DangerousPrototypes/Bus_Pirate_Ultra/hardware/scratch/BusPirate-ultra-proto-adj_vreg.v.0.brd

## EAGLE design hardware/scratch/BusPirate-ultra-proto-adj_vreg.v.0.brd (2019-07-15)

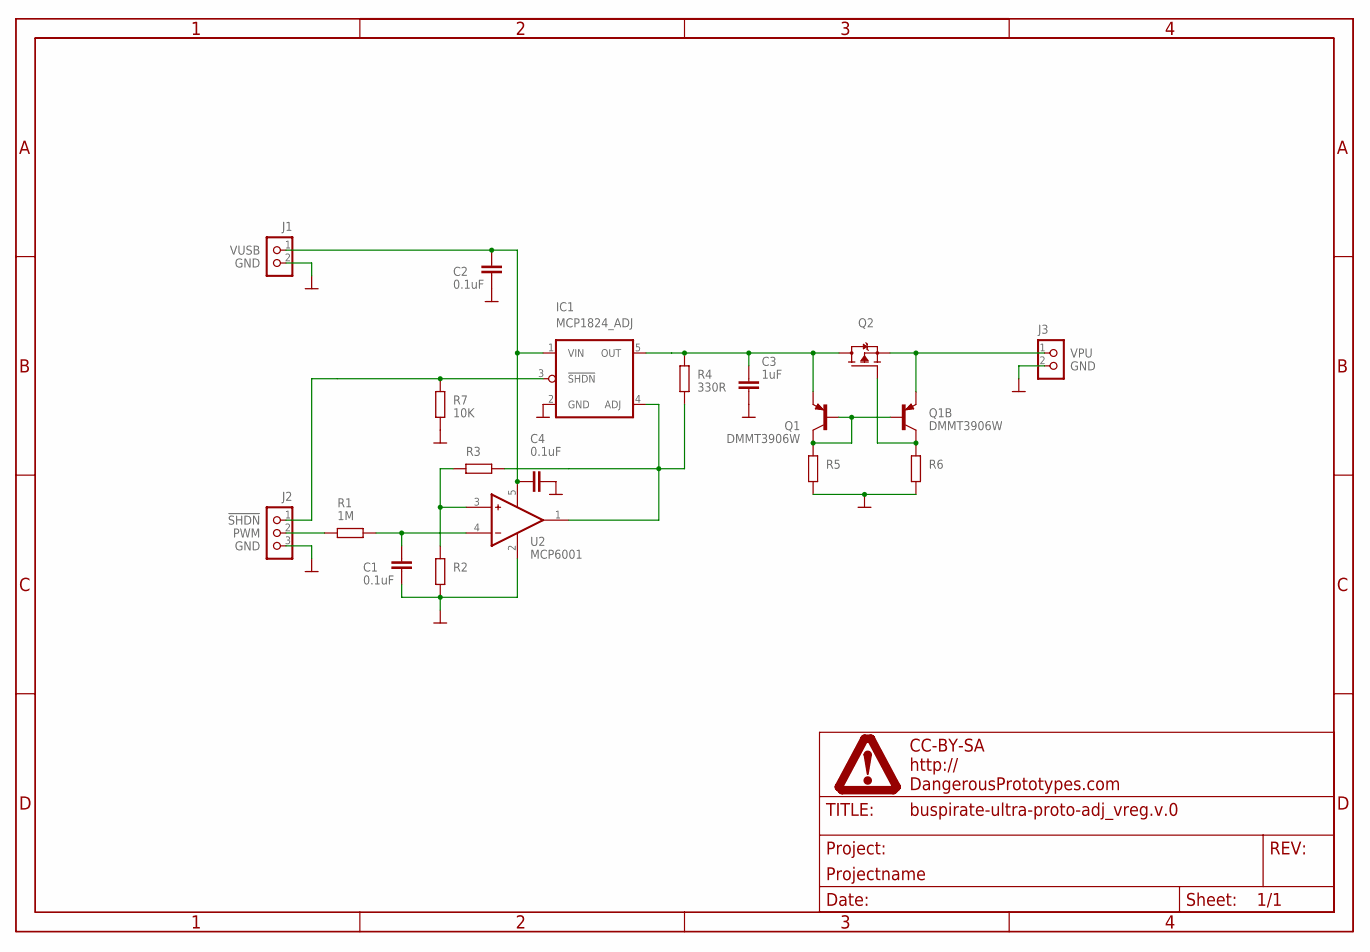
[picture p1: schematic BusPirate-ultra-proto-adj_vreg.v.0.sch]

Parts:
C1, C2, C4: 0.1uF; C603
C3: 1uF; C603
IC1: MCP1824_ADJ; SOT-23-5
J1, J3: CON_HEADER_1X02-PTH; M1X2
J2: CON_HEADER_1X03-PTH; M1X3
PAGE1: FRAME_DINA4_L; DP_LOGO
Q1: DMMT3906W; SOT-363
Q2: TRANSISTOR_FET_TSM2301CX; SOT-23
R1: 1M; R603
R2, R3, R5, R6: RESISTOR-0603; R603
R4: 330R; R603
R7: 10K; R603
U2: MCP6001; SOT-23-5

Connections:
!SHDN: IC1.3 (!SHDN), J2.1, R7.1
GND: C1.2, C2.2, C3.2, C4.2, IC1.2 (GND), J1.2, J2.3, J3.2, R2.2, R5.1, R6.1, R7.2, U2.2 (V-)
unnamed: C3.1, IC1.5 (OUT), Q1.4 (E), Q2.3 (D), R4.2
unnamed: Q1.1 (B), Q1.2 (B), Q1.3 (C), R5.2
unnamed: Q1.6 (C), Q2.1 (G), R6.2
unnamed: IC1.4 (ADJ), R3.1, R4.1, U2.1 (OUT)
unnamed: R2.1, R3.2, U2.3 (+)
unnamed: C1.1, R1.1, U2.4 (-)
PWM: J2.2, R1.2
VPU: J3.1, Q1.5 (E), Q2.2 (S)
VUSB: C2.1, C4.1, IC1.1 (VIN), J1.1, U2.5 (V+)

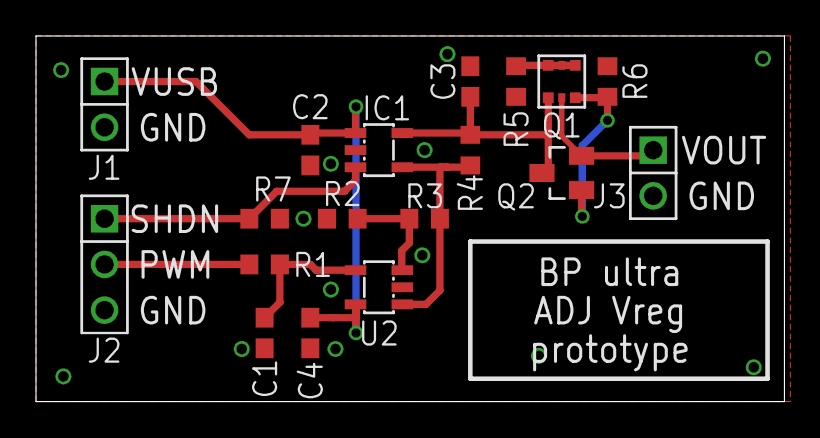
[picture p2: board BusPirate-ultra-proto-adj_vreg.v.0.brd from above]

Board: 2 copper layers, 41.6 x 20.3 mm, 19 parts (0 on the bottom side), 11 nets.
