DangerousPrototypes/Bus_Pirate_Ultra/hardware/scratch/BusPirate-ultra-testboard.v1.0.brd

## EAGLE design hardware/scratch/BusPirate-ultra-testboard.v1.0.brd (2019-07-15)

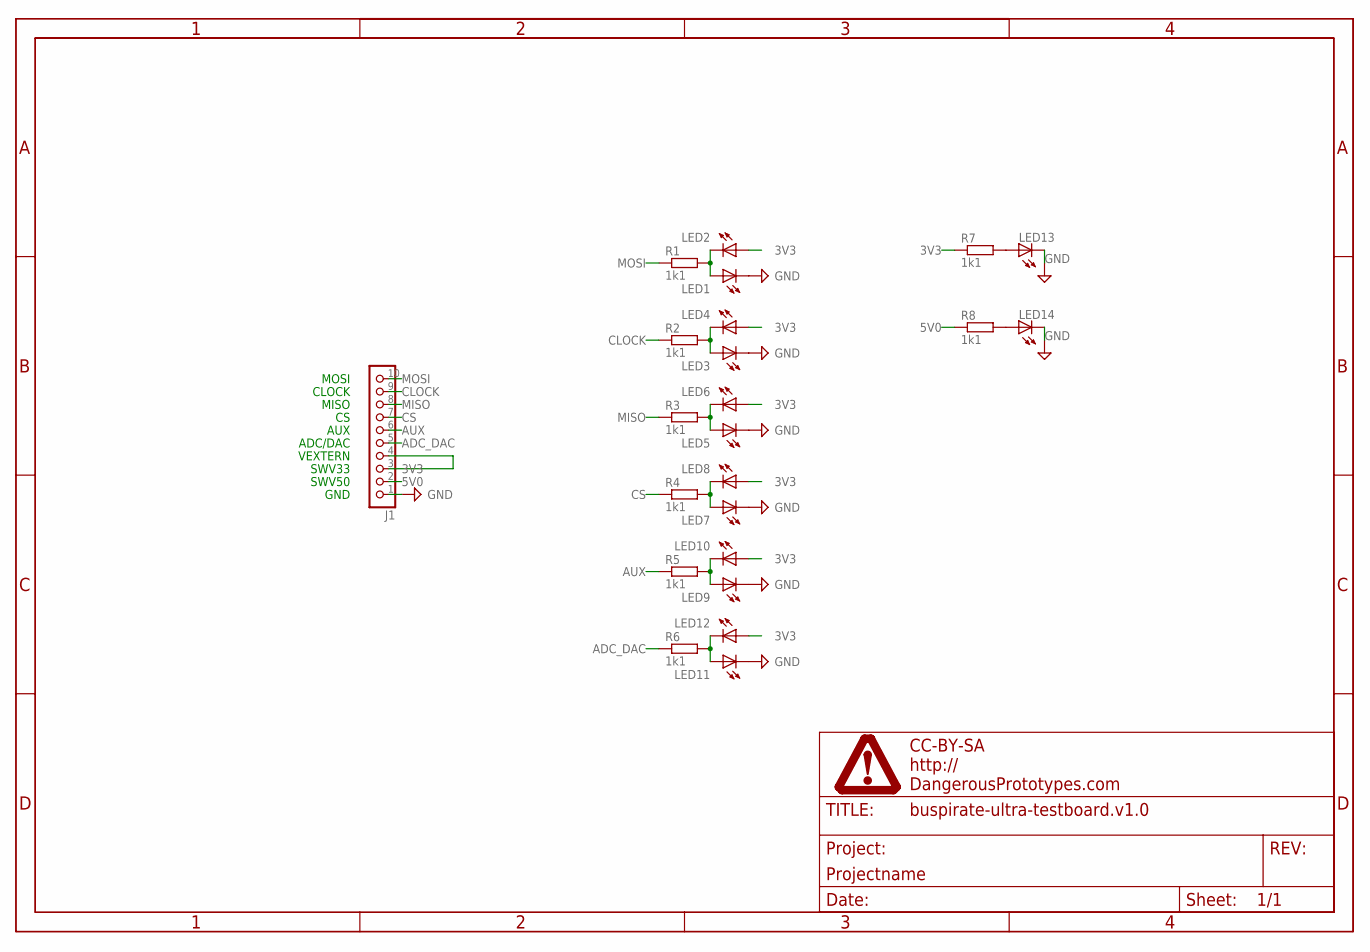
[picture p3: schematic BusPirate-ultra-testboard.v1.0.sch]

Parts:
J1: CON_HEADER_1X10-RIGHT_ANGLED_PTH; M1X10_FEMALE_RIGHT_ANGLED_PTH
LED1, LED2, LED3, LED4, LED5, LED6, LED7, LED8, LED9, LED10, LED11, LED12, LED13, LED14: LED-0805; LED-805
PAGE1: FRAME_DINA4_L; DP_LOGO
R1, R2, R3, R4, R5, R6, R7, R8: 1k1; R603

Connections:
3V3: J1.3, J1.4, LED2.A, LED4.A, LED6.A, LED8.A, LED10.A, LED12.A, R7.1
5V0: J1.2, R8.1
ADC_DAC: J1.5, R6.1
AUX: J1.6, R5.1
CLOCK: J1.9, R2.1
CS: J1.7, R4.1
GND: J1.1, LED1.C, LED3.C, LED5.C, LED7.C, LED9.C, LED11.C, LED13.C, LED14.C
MISO: J1.8, R3.1
MOSI: J1.10, R1.1
unnamed: LED1.A, LED2.C, R1.2
unnamed: LED3.A, LED4.C, R2.2
unnamed: LED5.A, LED6.C, R3.2
unnamed: LED7.A, LED8.C, R4.2
unnamed: LED9.A, LED10.C, R5.2
unnamed: LED11.A, LED12.C, R6.2
unnamed: LED14.A, R8.2
unnamed: LED13.A, R7.2

Notes on the sheet:
MOSI
CLOCK
MISO
AUX
ADC/DAC
VEXTERN
SWV33
SWV50
GND

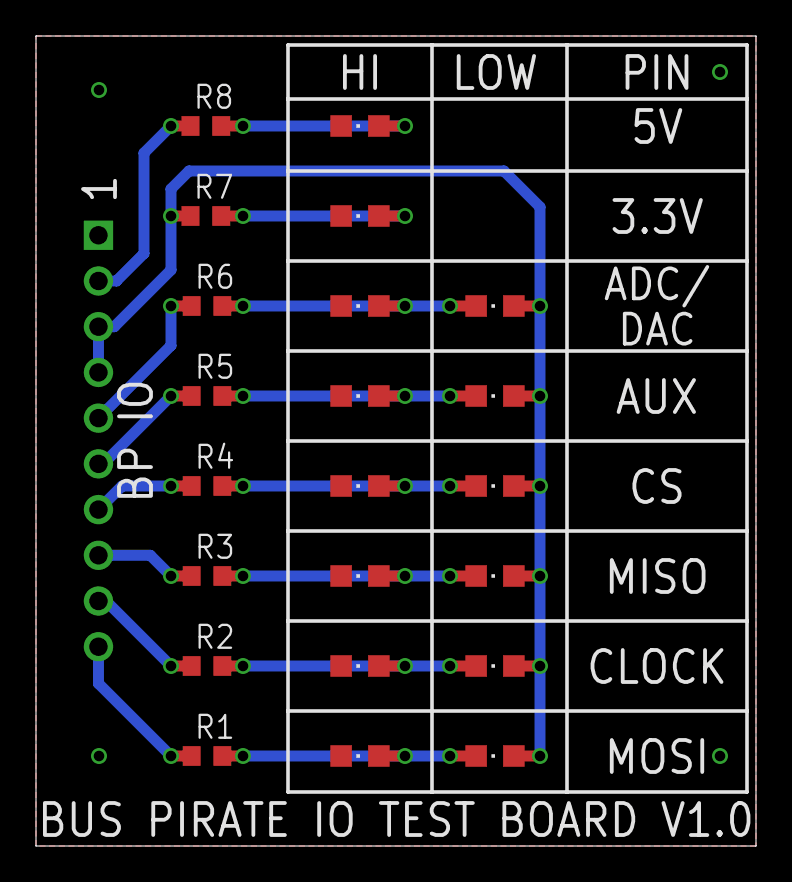
[picture p4: board BusPirate-ultra-testboard.v1.0.brd from above]

Board: 2 copper layers, 40.0 x 45.0 mm, 24 parts (1 on the bottom side), 17 nets.
