DangerousPrototypes/Bus_Pirate_Ultra/hardware/scratch/BusPirate-ng.v4.0.brd

## EAGLE design hardware/scratch/BusPirate-ng.v4.0.brd (2019-06-05)

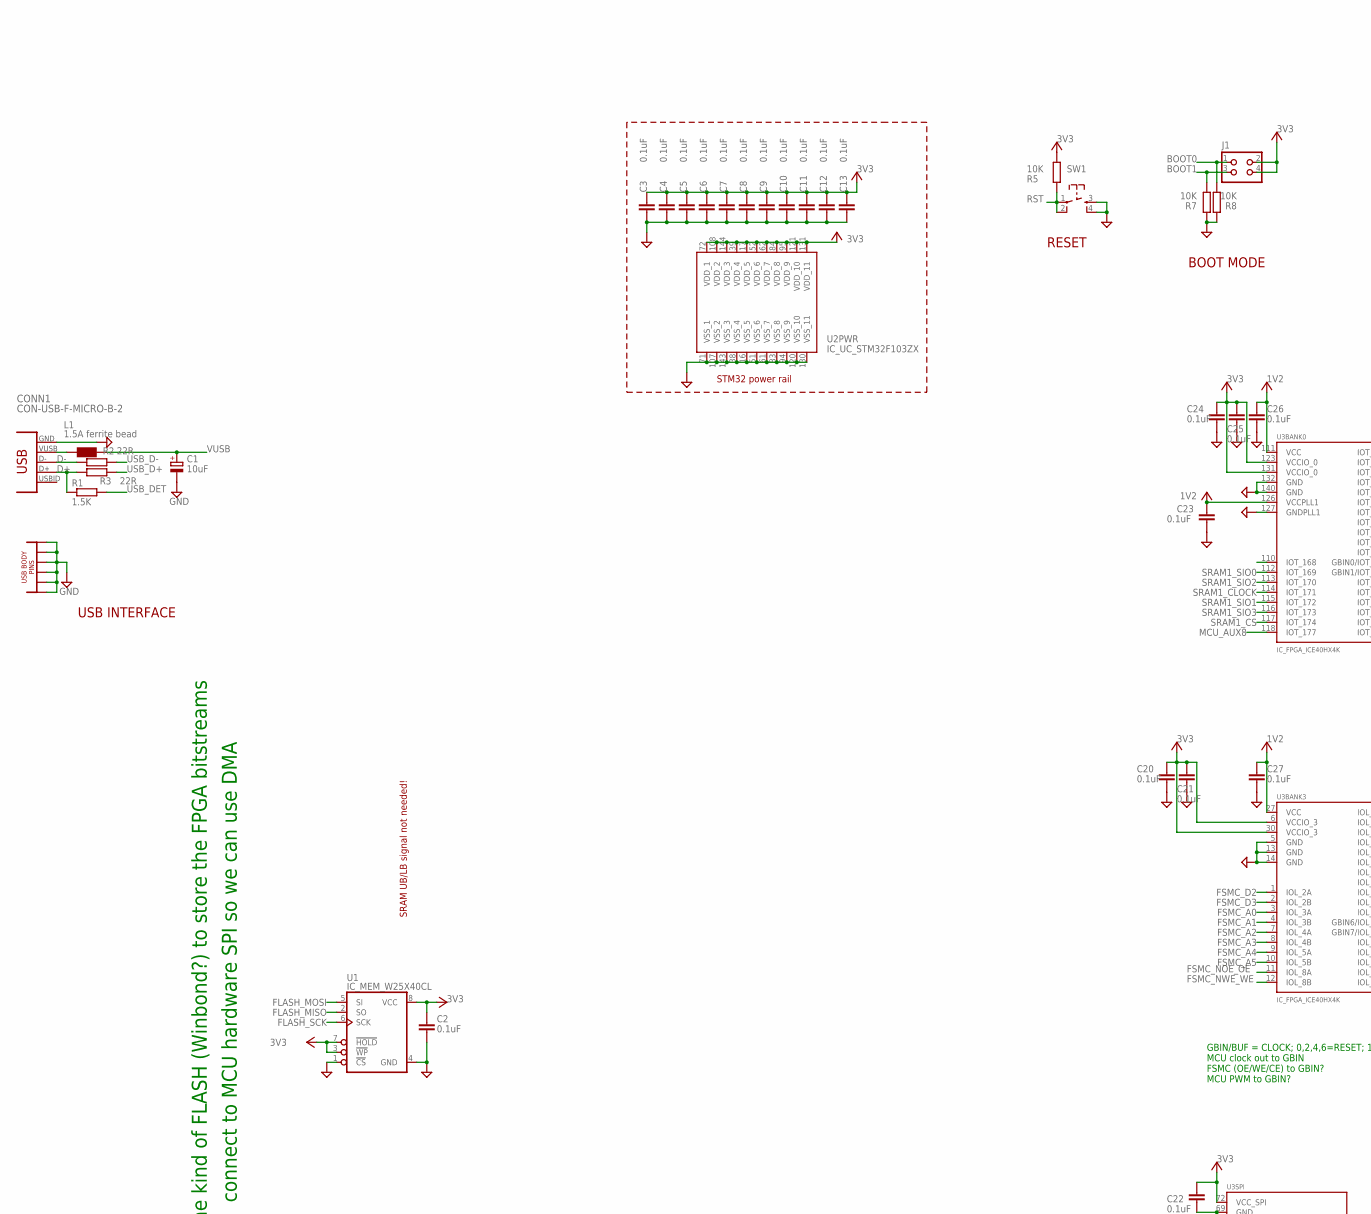
[picture p5: schematic BusPirate-ng.v4.0.sch, part in row 1, column 1]

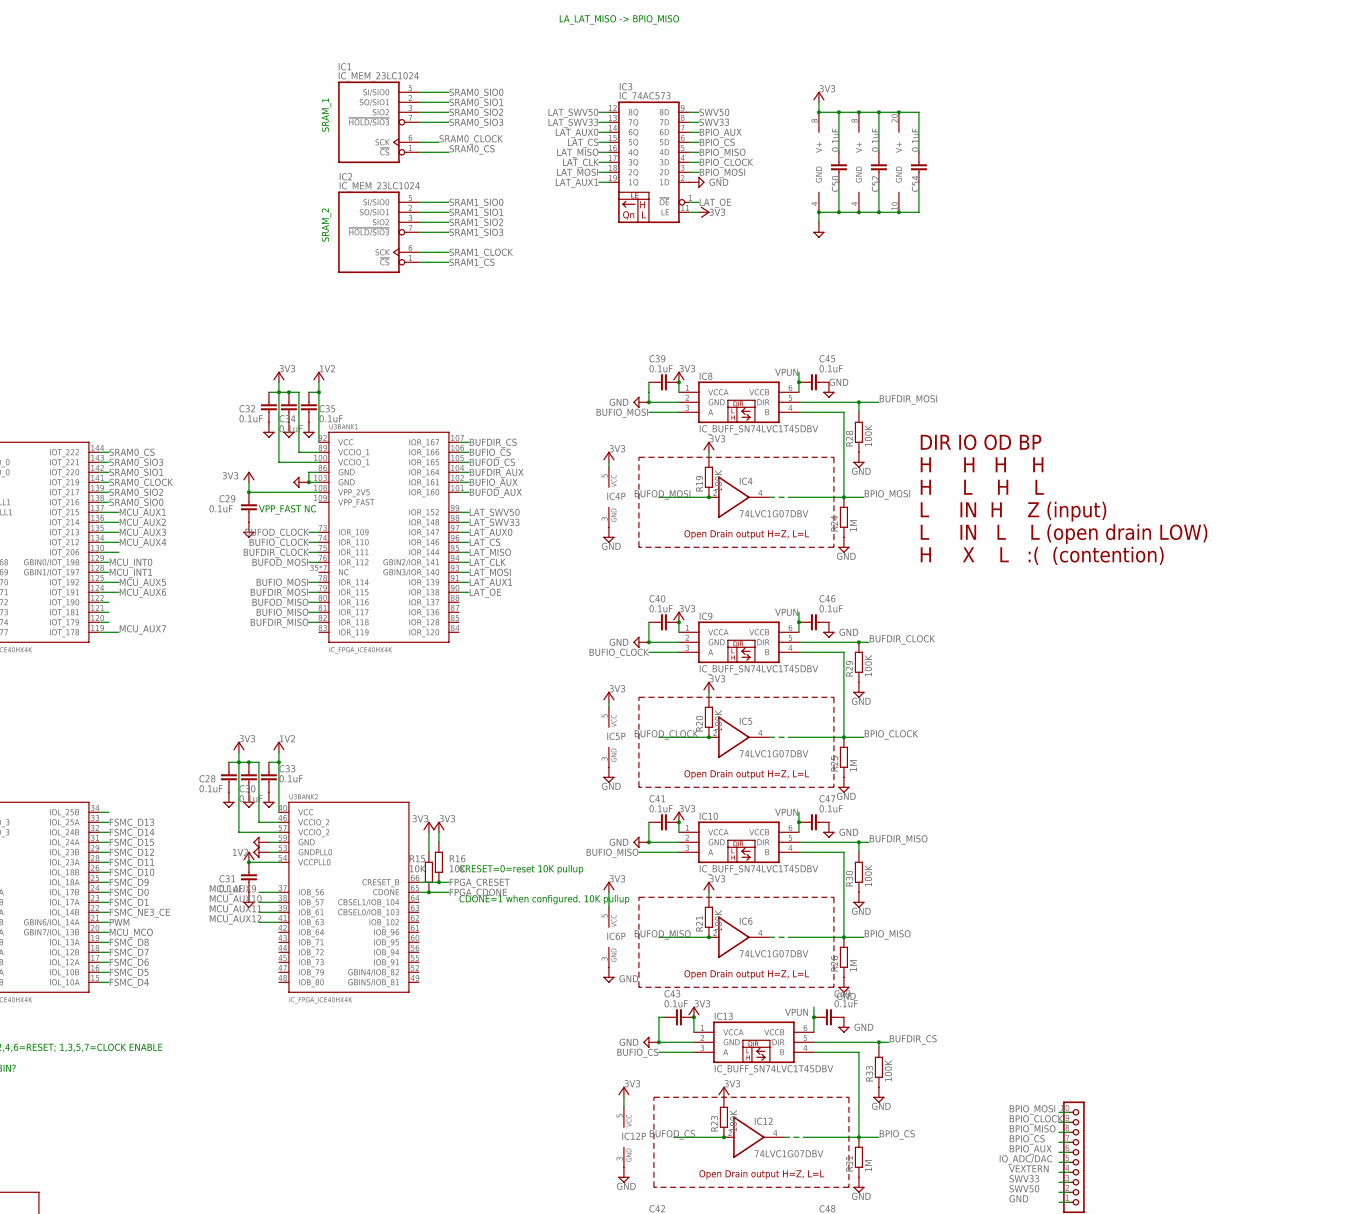
[picture p6: schematic BusPirate-ng.v4.0.sch, part in row 1, column 2]

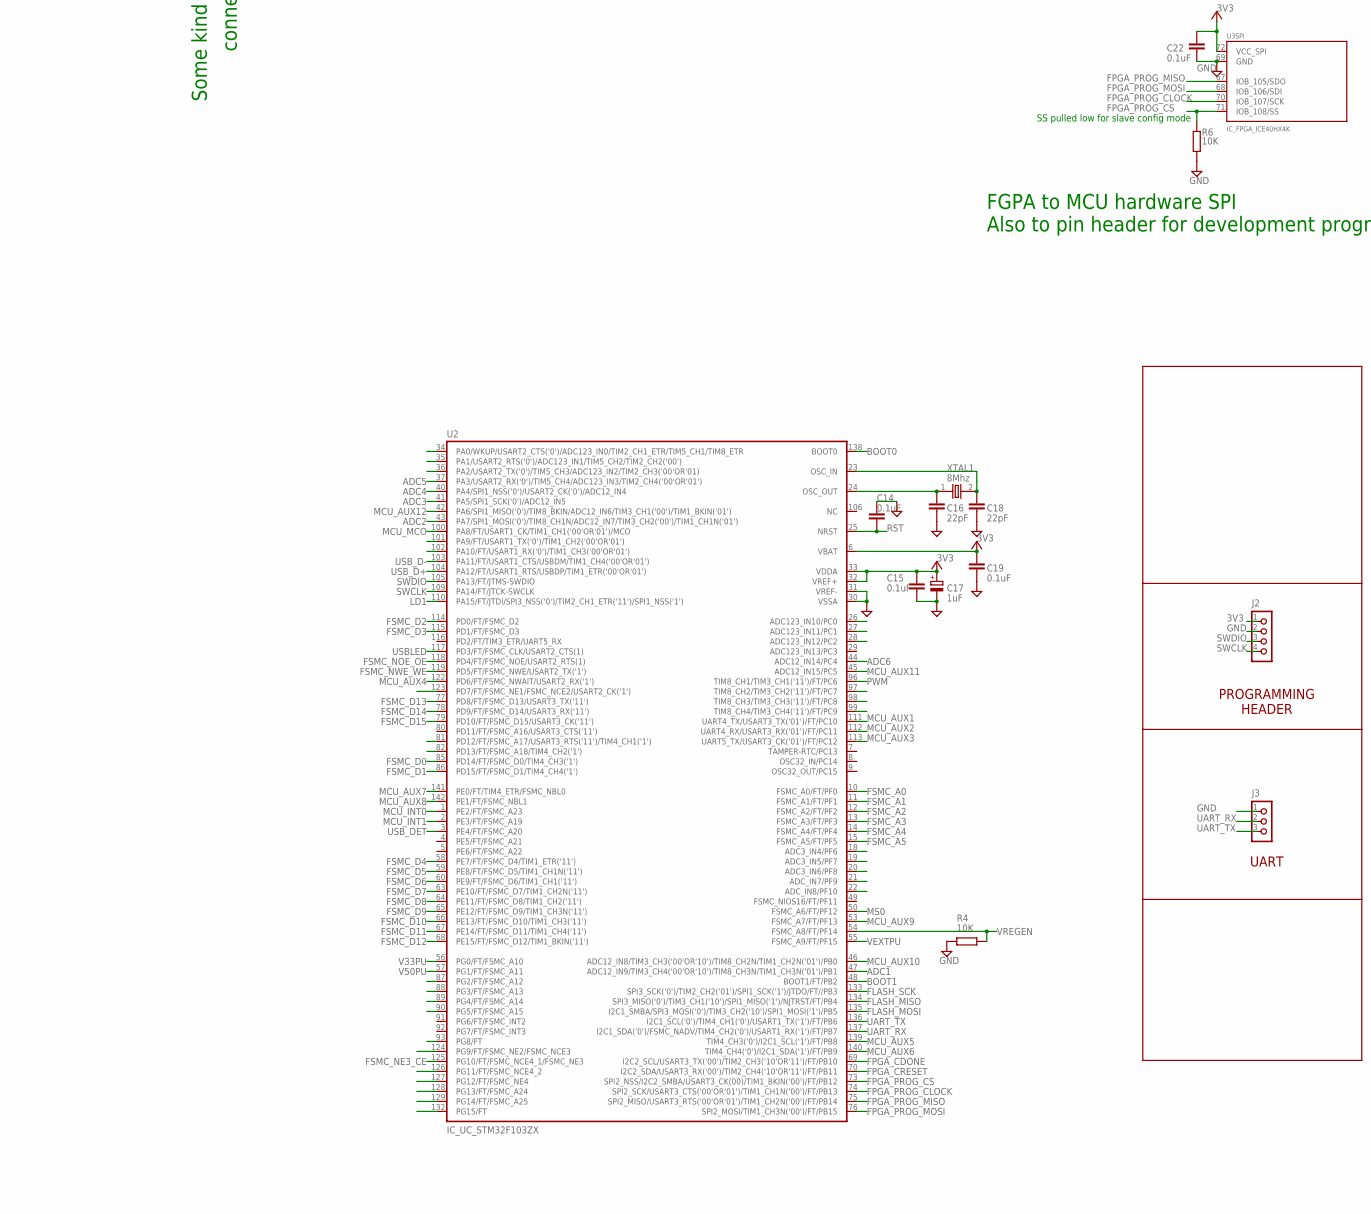
[picture p7: schematic BusPirate-ng.v4.0.sch, part in row 2, column 1]

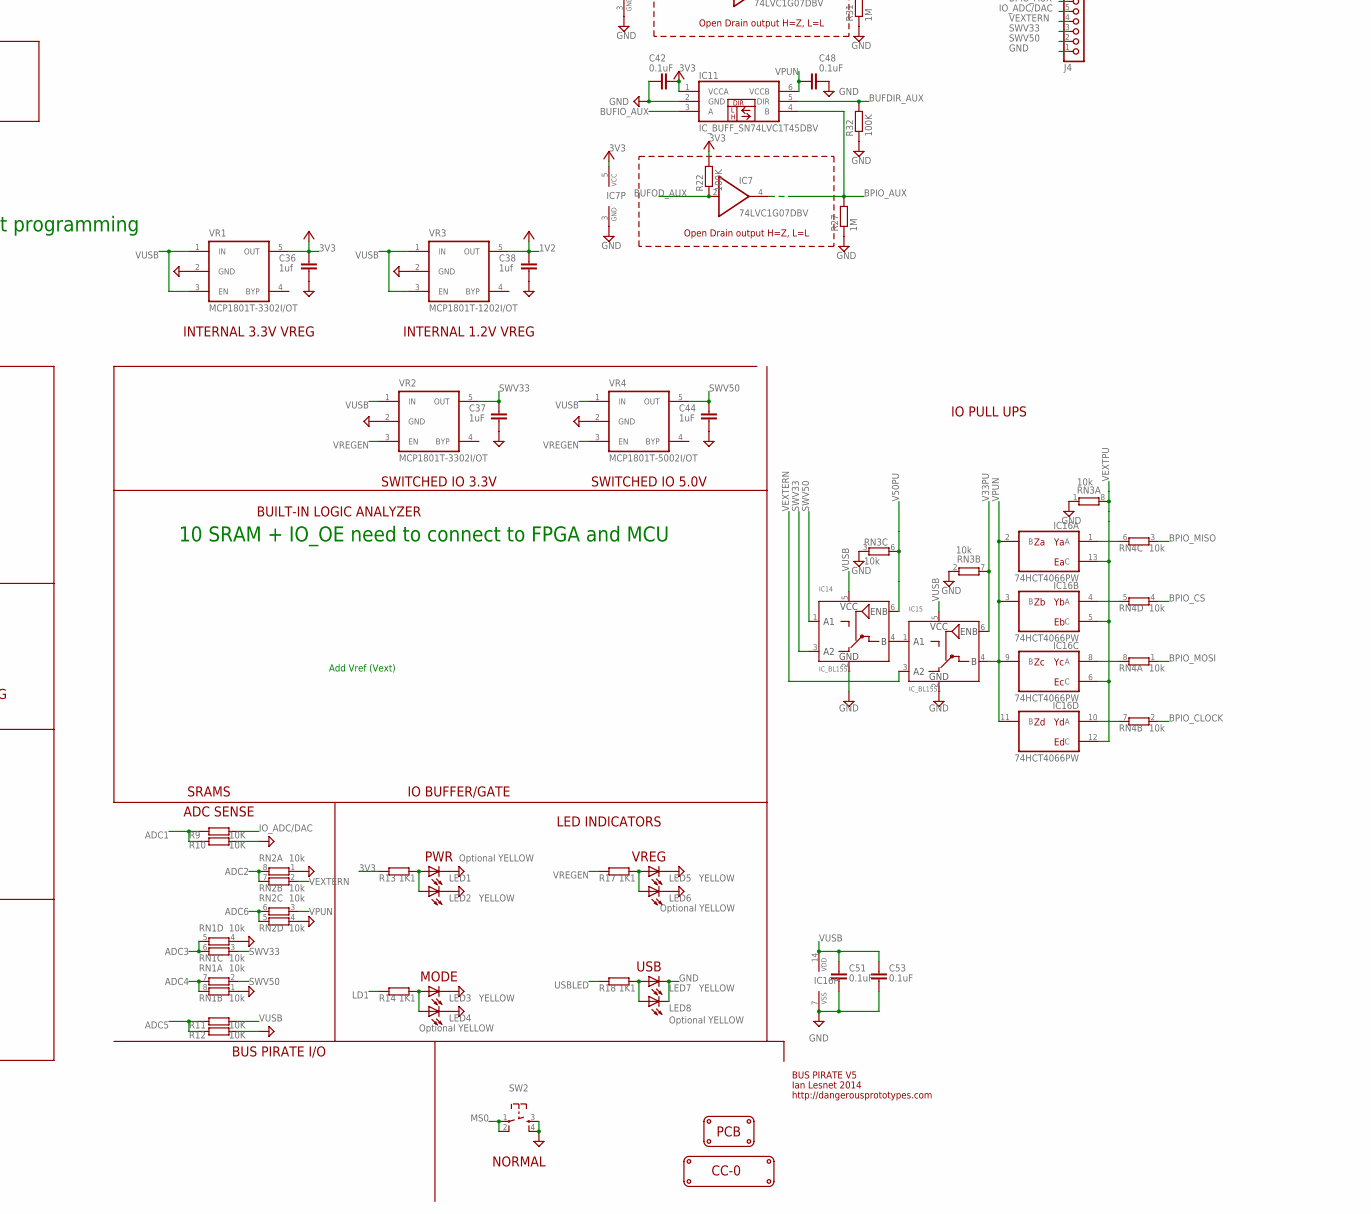
[picture p8: schematic BusPirate-ng.v4.0.sch, part in row 2, column 2]

Parts:
C1: 10uF; SMC_A
C2, C3, C4, C5, C6, C7, C8, C9, C11, C12, C13, C14, C15, C19, C21, C22, C23, C24, C25, C26, C28, C29, C30, C31, C32, C33, C34, C35, C39, C40, C41, C42, C43, C45, C46, C47, C48, C49, C50, C51, C52, C53, C54: 0.1uF; C0603
C10, C20, C27: 0.1uF; C402
C16, C18: 22pF; C0603
C17: 1uF; SMC_A
C36, C38: 1uf; C0603
C37, C44: 1uF; C0603
CONN1: CON-USB-F-MICRO-B-2; CON_USB_MICRO-B-2-SD-47589-001
IC1, IC2: IC_MEM_23LC1024; SOIC-8
IC3: IC_74AC573; TSSOP-20
IC4, IC5, IC6, IC7, IC12: 74LVC1G07DBV; SOT23-5
IC8, IC9, IC10, IC11, IC13: IC_BUFF_SN74LVC1T45DBV; DBV-R-PDSO-G6
IC14, IC15: IC_BL1551; SC-70-6
IC16: 74HCT4066PW; 40XX_TSSOP14
J1: CON_HEADER_2X02-PTH; M2X2
J2: CON_HEADER_1X04; M1X4
J3: CON_HEADER_1X03-PTH; M1X3
J4: CON_HEADER_1X10-RIGHT_ANGLED_PTH_SHROUDED; M1X10_MALE_RIGHT_ANGLES_PTH_SHROUDED
L1: 1.5A ferrite bead; WE-KI_0805_B
LED1, LED4, LED6, LED8: Optional YELLOW; LED-805
LED2, LED3, LED5, LED7: YELLOW; LED-805
LOGO1: LOGO_CC-0
PCB1: PCB_DP_RECTANGLE-50X100; DP10050_V1
R1: 1.5K; R603
R2, R3: 22R; R603
R4, R5, R6: 10K; R603
R7, R8, R9, R10, R11, R12, R15, R16: 10K; R0603
R13, R14, R17, R18: 1K1; R603
R19, R20, R21, R22, R23, R28, R29, R30, R32, R33: 100K; R0603
R24, R25, R26, R27, R31: 1M; R0603
RN1, RN2, RN3, RN4: 10k; RN8P-4R-CRA06S
SW1, SW2: SW_TACT_4P; SW_TACT_SMALL
U1: IC_MEM_W25X40CL; SOIC-8
U2: IC_UC_STM32F103ZX; TQFP-144
U3: IC_FPGA_ICE40HX4K; TQFP-144
VR1, VR2: MCP1801T-3302I/OT; SOT-23-5@1
VR3: MCP1801T-1202I/OT; SOT-23-5@1
VR4: MCP1801T-5002I/OT; SOT-23-5@1
XTAL1: 8Mhz; XTAL_4X6

Connections:
1V2: C23.2, C26.2, C27.1, C31.2, C33.2, C35.2, C38.1, U3.27 (VCC), U3.40 (VCC), U3.54 (VCCPLL0), U3.92 (VCC), U3.111 (VCC), U3.126 (VCCPLL1), VR3.5 (OUT)
3V3: C2.2, C3.2, C4.2, C5.2, C6.2, C7.2, C8.2, C9.2, C10.1, C11.2, C12.2, C13.2, C15.2, C17.+, C19.2, C20.1, C21.2, C22.2, C24.2, C25.2, C28.2, C29.2, C30.2, C32.2, C34.2, C36.1, C39.1, C40.1, C41.1, C42.1, C43.1, C50.1, C52.1, C54.1, IC1.8 (V+), IC2.8 (V+), IC3.11 (LE), IC3.20 (V+), IC4.5 (VCC), IC5.5 (VCC), IC6.5 (VCC), IC7.5 (VCC), IC8.1 (VCCA), IC9.1 (VCCA), IC10.1 (VCCA), IC11.1 (VCCA), IC12.5 (VCC), IC13.1 (VCCA), J1.2, J1.4, J2.1, R5.2, R13.2, R15.2, R16.2, R19.2, R20.2, R21.2, R22.2, R23.2, U1.3 (!WP), U1.7 (!HOLD), U1.8 (VCC), U2.6 (VBAT), U2.17 (VDD_5), U2.32 (VREF+), U2.33 (VDDA), U2.39 (VDD_4), U2.52 (VDD_6), U2.62 (VDD_7), U2.72 (VDD_1), U2.84 (VDD_8), U2.95 (VDD_9), U2.108 (VDD_2), U2.121 (VDD_10), U2.131 (VDD_11), U2.144 (VDD_3), U3.6 (VCCIO_3), U3.30 (VCCIO_3), U3.46 (VCCIO_2), U3.57 (VCCIO_2), U3.72 (VCC_SPI), U3.89 (VCCIO_1), U3.100 (VCCIO_1), U3.108 (VPP_2V5), U3.123 (VCCIO_0), U3.131 (VCCIO_0), VR1.5 (OUT)
ADC1: R9.2, R10.2, U2.47 (ADC12_IN9/TIM3_CH4('00'OR'10')/TIM8_CH3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)
ADC2: RN2.7 (2), RN2.8 (2), U2.43 (PA7/SPI1_MOSI('0')/TIM8_CH1N/ADC12_IN7/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)
ADC3: RN1.5 (2), RN1.6 (2), U2.41 (PA5/SPI1_SCK('0')/ADC12_IN5)
ADC4: RN1.7 (2), RN1.8 (2), U2.40 (PA4/SPI1_NSS('0')/USART2_CK('0')/ADC12_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)
ADC5: R11.2, R12.2, U2.37 (PA3/USART2_RX('0')/TIM5_CH4/ADC123_IN3/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)
ADC6: RN2.5 (2), RN2.6 (2), U2.44 (ADC12_IN14/PC4)
BOOT0: J1.1, R8.1, U2.138 (BOOT0)
BOOT1: J1.3, R7.1, U2.48 (BOOT1/FT/PB2)
BPIO_AUX: IC3.7 (6D), IC7.4 (O), IC11.4 (B), J4.6, R27.2
BPIO_CLOCK: IC3.4 (3D), IC5.4 (O), IC9.4 (B), J4.9, R25.2, RN4.2 (1)
BPIO_CS: IC3.6 (5D), IC12.4 (O), IC13.4 (B), J4.7, R31.2, RN4.4 (1)
BPIO_MISO: IC3.5 (4D), IC6.4 (O), IC10.4 (B), J4.8, R26.2, RN4.3 (1)
BPIO_MOSI: IC3.3 (2D), IC4.4 (O), IC8.4 (B), J4.10, R24.2, RN4.1
BUFDIR_AUX: IC11.5 (DIR), R32.2, U3.104 (IOR_164)
BUFDIR_CLOCK: IC9.5 (DIR), R29.2, U3.75 (IOR_111)
BUFDIR_CS: IC13.5 (DIR), R33.2, U3.107 (IOR_167)
BUFDIR_MISO: IC10.5 (DIR), R30.2, U3.82 (IOR_118)
BUFDIR_MOSI: IC8.5 (DIR), R28.2, U3.79 (IOR_115)
BUFIO_AUX: IC11.3 (A), U3.102 (IOR_161)
BUFIO_CLOCK: IC9.3 (A), U3.74 (IOR_110)
BUFIO_CS: IC13.3 (A), U3.106 (IOR_166)
BUFIO_MISO: IC10.3 (A), U3.81 (IOR_117)
BUFIO_MOSI: IC8.3 (A), U3.78 (IOR_114)
BUFOD_AUX: IC7.2 (I), R22.1, U3.101 (IOR_160)
BUFOD_CLOCK: IC5.2 (I), R20.1, U3.73 (IOR_109)
BUFOD_CS: IC12.2 (I), R23.1, U3.105 (IOR_165)
BUFOD_MISO: IC6.2 (I), R21.1, U3.80 (IOR_116)
BUFOD_MOSI: IC4.2 (I), R19.1, U3.76 (IOR_112)
D+: CONN1.P3 (D+), R1.1, R3.2
D-: CONN1.P2 (D-), R2.2
EXVUSB: CONN1.P1 (VUSB), L1.2 (1)
FLASH_MISO: U1.2 (SO), U2.134 (SPI3_MISO('0')/TIM3_CH1('10')/SPI1_MISO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)
FLASH_MOSI: U1.5 (SI), U2.135 (I2C1_SMBA/SPI3_MOSI('0')/TIM3_CH2('10')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)
FLASH_SCK: U1.6 (SCK), U2.133 (SPI3_SCK('0')/TIM2_CH2('01')/SPI1_SCK('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)
FPGA_CDONE: R15.1, U2.69 (I2C2_SCL/USART3_TX('00')/TIM2_CH3('10'O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), U3.65 (CDONE)
FPGA_CRESET: R16.1, U2.70 (I2C2_SDA/USART3_RX('00')/TIM2_CH4('10'O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), U3.66 (CRESET_B)
FPGA_PROG_CLOCK: U2.74 (SPI2_SCK/USART3_CTS('00'OR'01')/TIM1_CH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), U3.70 (IOB_107/SCK)
FPGA_PROG_CS: R6.1, U2.73 (SPI2_NSS/I2C2_SMBA/USART3_CK(00)/TIM1_B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), U3.71 (IOB_108/SS)
FPGA_PROG_MISO: U2.75 (SPI2_MISO/USART3_RTS('00'OR'01')/TIM1_C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), U3.67 (IOB_105/SDO)
FPGA_PROG_MOSI: U2.76 (SPI2_MOSI/TIM1_CH3N('00')/FT/PB15), U3.68 (IOB_106/SDI)
FSMC_A0: U2.10 (FSMC_A0/FT/PF0), U3.3 (IOL_3A)
FSMC_A1: U2.11 (FSMC_A1/FT/PF1), U3.4 (IOL_3B)
FSMC_A2: U2.12 (FSMC_A2/FT/PF2), U3.7 (IOL_4A)
FSMC_A3: U2.13 (FSMC_A3/FT/PF3), U3.8 (IOL_4B)
FSMC_A4: U2.14 (FSMC_A4/FT/PF4), U3.9 (IOL_5A)
FSMC_A5: U2.15 (FSMC_A5/FT/PF5), U3.10 (IOL_5B)
FSMC_D0: U2.85 (PD14/FT/FSMC_D0/TIM4_CH3('1')), U3.24 (IOL_17B)
FSMC_D1: U2.86 (PD15/FT/FSMC_D1/TIM4_CH4('1')), U3.23 (IOL_17A)
FSMC_D2: U2.114 (PD0/FT/FSMC_D2), U3.1 (IOL_2A)
FSMC_D3: U2.115 (PD1/FT/FSMC_D3), U3.2 (IOL_2B)
FSMC_D4: U2.58 (PE7/FT/FSMC_D4/TIM1_ETR('11')), U3.15 (IOL_10A)
FSMC_D5: U2.59 (PE8/FT/FSMC_D5/TIM1_CH1N('11')), U3.16 (IOL_10B)
FSMC_D6: U2.60 (PE9/FT/FSMC_D6/TIM1_CH1('11')), U3.17 (IOL_12A)
FSMC_D7: U2.63 (PE10/FT/FSMC_D7/TIM1_CH2N('11')), U3.18 (IOL_12B)
FSMC_D8: U2.64 (PE11/FT/FSMC_D8/TIM1_CH2('11')), U3.19 (IOL_13A)
FSMC_D9: U2.65 (PE12/FT/FSMC_D9/TIM1_CH3N('11')), U3.25 (IOL_18A)
FSMC_D10: U2.66 (PE13/FT/FSMC_D10/TIM1_CH3('11')), U3.26 (IOL_18B)
FSMC_D11: U2.67 (PE14/FT/FSMC_D11/TIM1_CH4('11')), U3.28 (IOL_23A)
FSMC_D12: U2.68 (PE15/FT/FSMC_D12/TIM1_BKIN('11')), U3.29 (IOL_23B)
FSMC_D13: U2.77 (PD8/FT/FSMC_D13/USART3_TX('11')), U3.33 (IOL_25A)
FSMC_D14: U2.78 (PD9/FT/FSMC_D14/USART3_RX('11')), U3.32 (IOL_24B)
FSMC_D15: U2.79 (PD10/FT/FSMC_D15/USART3_CK('11')), U3.31 (IOL_24A)
FSMC_NE3_CE: U2.125 (PG10/FT/FSMC_NCE4_1/FSMC_NE3), U3.22 (IOL_14B)
FSMC_NOE_OE: U2.118 (PD4/FT/FSMC_NOE/USART2_RTS(1)), U3.11 (IOL_8A)
FSMC_NWE_WE: U2.119 (PD5/FT/FSMC_NWE/USART2_TX('1')), U3.12 (IOL_8B)
GND: C1.-, C2.1, C3.1, C4.1, C5.1, C6.1, C7.1, C8.1, C9.1, C10.2, C11.1, C12.1, C13.1, C14.1, C15.1, C16.1, C17.-, C18.1, C19.1, C20.2, C21.1, C22.1, C23.1, C24.1, C25.1, C26.1, C27.2, C28.1, C29.1, C30.1, C31.1, C32.1, C33.1, C34.1, C35.1, C36.2, C37.2, C38.2, C39.2, C40.2, C41.2, C42.2, C43.2, C44.2, C45.1, C46.1, C47.1, C48.1, C49.1, C50.2, C51.2, C52.2, C53.2, C54.2, CONN1.BODY@1, CONN1.BODY@2, CONN1.BODY@3, CONN1.BODY@4, CONN1.BODY@5, CONN1.BODY@6, CONN1.BODY@7, CONN1.BODY@8, CONN1.BODY@9, CONN1.BODY@10, CONN1.P5 (GND), IC1.4 (GND), IC2.4 (GND), IC3.2 (1D), IC3.10 (GND), IC4.3 (GND), IC5.3 (GND), IC6.3 (GND), IC7.3 (GND), IC8.2 (GND), IC9.2 (GND), IC10.2 (GND), IC11.2 (GND), IC12.3 (GND), IC13.2 (GND), IC14.2 (GND), IC15.2 (GND), IC16.7 (VSS), J2.2, J3.1, J4.1, LED1.C, LED2.C, LED3.C, LED4.C, LED5.C, LED6.C, LED7.C, LED8.C, R4.2, R6.2, R7.2, R8.2, R10.1, R12.1, R24.1, R25.1, R26.1, R27.1, R28.1, R29.1, R30.1, R31.1, R32.1, R33.1, RN1.1, RN1.4 (1), RN2.1, RN2.4 (1), RN3.1, RN3.2 (1), RN3.3 (1), SW1.3, SW1.4, SW2.3, SW2.4, U1.1 (!CS), U1.4 (GND), U2.16 (VSS_5), U2.30 (VSSA), U2.31 (VREF-), U2.38 (VSS_4), U2.51 (VSS_6), U2.61 (VSS_7), U2.71 (VSS_1), U2.83 (VSS_8), U2.94 (VSS_9), U2.107 (VSS_2), U2.120 (VSS_10), U2.130 (VSS_11), U2.143 (VSS_3), U3.5 (GND), U3.13 (GND), U3.14 (GND), U3.53 (GNDPLL0), U3.59 (GND), U3.69 (GND), U3.86 (GND), U3.103 (GND), U3.127 (GNDPLL1), U3.132 (GND), U3.140 (GND), VR1.2 (GND), VR2.2 (GND), VR3.2 (GND), VR4.2 (GND)
IO_ADC/DAC: J4.5, R9.1
LAT_AUX0: IC3.14 (6Q), U3.97 (IOR_147)
LAT_AUX1: IC3.19 (1Q), U3.91 (IOR_139)
LAT_CLK: IC3.17 (3Q), U3.94 (GBIN2/IOR_141)
LAT_CS: IC3.15 (5Q), U3.96 (IOR_146)
LAT_MISO: IC3.16 (4Q), U3.95 (IOR_144)
LAT_MOSI: IC3.18 (2Q), U3.93 (GBIN3/IOR_140)
LAT_OE: IC3.1 (!OE), U3.90 (IOR_138)
LAT_SWV33: IC3.13 (7Q), U3.98 (IOR_148)
LAT_SWV50: IC3.12 (8Q), U3.99 (IOR_152)
LD1: R14.2, U2.110 (PA15/FT/JTDI/SPI3_NSS('0')/TIM2_CH1_ETR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)
MCU_AUX1: U2.111 (UART4_TX/USART3_TX('01')/FT/PC10), U3.137 (IOT_215)
MCU_AUX2: U2.112 (UART4_RX/USART3_RX('01')/FT/PC11), U3.136 (IOT_214)
MCU_AUX3: U2.113 (UART5_TX/USART3_CK('01')/FT/PC12), U3.135 (IOT_213)
MCU_AUX4: U2.122 (PD6/FT/FSMC_NWAIT/USART2_RX('1')), U3.134 (IOT_212)
MCU_AUX5: U2.139 (TIM4_CH3('0')/I2C1_SCL('1')/FT/PB8), U3.125 (IOT_192)
MCU_AUX6: U2.140 (TIM4_CH4('0')/I2C1_SDA('1')/FT/PB9), U3.124 (IOT_191)
MCU_AUX7: U2.141 (PE0/FT/TIM4_ETR/FSMC_NBL0), U3.119 (IOT_178)
MCU_AUX8: U2.142 (PE1/FT/FSMC_NBL1), U3.118 (IOT_177)
MCU_AUX9: U2.53 (FSMC_A7/FT/PF13), U3.37 (IOB_56)
MCU_AUX10: U2.46 (ADC12_IN8/TIM3_CH3('00'OR'10')/TIM8_CH2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), U3.38 (IOB_57)
MCU_AUX11: U2.45 (ADC12_IN15/PC5), U3.39 (IOB_61)
MCU_AUX12: U2.42 (PA6/SPI1_MISO('0')/TIM8_BKIN/ADC12_IN6/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), U3.41 (IOB_63)
MCU_INT0: U2.1 (PE2/FT/FSMC_A23), U3.129 (GBIN0/IOT_198)
MCU_INT1: U2.2 (PE3/FT/FSMC_A19), U3.128 (GBIN1/IOT_197)
MCU_MCO: U2.100 (PA8/FT/USART1_CK/TIM1_CH1('00'OR'01')/M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), U3.20 (GBIN7/IOL_13B)
MS0: SW2.1, SW2.2, U2.50 (FSMC_A6/FT/PF12)
unnamed: IC14.4 (B), IC15.1 (A1)
unnamed: IC16.1 (A), RN4.6 (2)
unnamed: IC16.4 (A), RN4.5 (2)
unnamed: IC16.8 (A), RN4.8 (2)
unnamed: IC16.10 (A), RN4.7 (2)
unnamed: LED3.A, LED4.A, R14.1
unnamed: LED1.A, LED2.A, R13.1
unnamed: C18.2, U2.23 (OSC_IN), XTAL1.2
unnamed: C16.2, U2.24 (OSC_OUT), XTAL1.1
unnamed: LED7.A, LED8.A, R18.1
unnamed: LED5.A, LED6.A, R17.1
PWM: U2.96 (TIM8_CH1/TIM3_CH1('11')/FT/PC6), U3.21 (GBIN6/IOL_14A)
RST: C14.2, R5.1, SW1.1, SW1.2, U2.25 (NRST)
SRAM0_CLOCK: IC1.6 (SCK), U3.141 (IOT_219)
SRAM0_CS: IC1.1 (!CS), U3.144 (IOT_222)
SRAM0_SIO0: IC1.5 (SI/SIO0), U3.138 (IOT_216)
SRAM0_SIO1: IC1.2 (SO/SIO1), U3.142 (IOT_220)
SRAM0_SIO2: IC1.3 (SIO2), U3.139 (IOT_217)
SRAM0_SIO3: IC1.7 (!HOLD/SIO3), U3.143 (IOT_221)
SRAM1_CLOCK: IC2.6 (SCK), U3.114 (IOT_171)
SRAM1_CS: IC2.1 (!CS), U3.117 (IOT_174)
SRAM1_SIO0: IC2.5 (SI/SIO0), U3.112 (IOT_169)
SRAM1_SIO1: IC2.2 (SO/SIO1), U3.115 (IOT_172)
SRAM1_SIO2: IC2.3 (SIO2), U3.113 (IOT_170)
SRAM1_SIO3: IC2.7 (!HOLD/SIO3), U3.116 (IOT_173)
SWCLK: J2.4, U2.109 (PA14/FT/JTCK-SWCLK)
SWDIO: J2.3, U2.105 (PA13/FT/JTMS-SWDIO)
SWV33: C37.1, IC3.8 (7D), IC14.3 (A2), J4.3, RN1.3 (1), VR2.5 (OUT)
SWV50: C44.1, IC3.9 (8D), IC14.1 (A1), J4.2, RN1.2 (1), VR4.5 (OUT)
UART_RX: J3.2, U2.137 (I2C1_SDA('0')/FSMC_NADV/TIM4_CH2('0')/U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)
UART_TX: J3.3, U2.136 (I2C1_SCL('0')/TIM4_CH1('0')/USART1_TX('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)
USBLED: R18.2, U2.117 (PD3/FT/FSMC_CLK/USART2_CTS(1))
USB_D+: R3.1, U2.104 (PA12/FT/USART1_RTS/USBDP/TIM1_ETR('00'O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)
USB_D-: R2.1, U2.103 (PA11/FT/USART1_CTS/USBDM/TIM1_CH4('00'O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)
USB_DET: R1.2, U2.3 (PE4/FT/FSMC_A20)
V33PU: IC15.6 (ENB), RN3.7 (2), U2.56 (PG0/FT/FSMC_A10)
V50PU: IC14.6 (ENB), RN3.6 (2), U2.57 (PG1/FT/FSMC_A11)
VEXTERN: IC15.3 (A2), J4.4, RN2.2 (1)
VEXTPU: IC16.5 (C), IC16.6 (C), IC16.12 (C), IC16.13 (C), RN3.8 (2), U2.55 (FSMC_A9/FT/PF15)
VPP_FAST: U3.109 (VPP_FAST)
VPUN: C45.2, C46.2, C47.2, C48.2, C49.2, IC8.6 (VCCB), IC9.6 (VCCB), IC10.6 (VCCB), IC11.6 (VCCB), IC13.6 (VCCB), IC15.4 (B), IC16.2 (B), IC16.3 (B), IC16.9 (B), IC16.11 (B), RN2.3 (1)
VREGEN: R4.1, R17.2, U2.54 (FSMC_A8/FT/PF14), VR2.3 (EN), VR4.3 (EN)
VUSB: C1.+, C51.1, C53.1, IC14.5 (VCC), IC15.5 (VCC), IC16.14 (VDD), L1.1 (2), R11.1, VR1.1 (IN), VR1.3 (EN), VR2.1 (IN), VR3.1 (IN), VR3.3 (EN), VR4.1 (IN)

Notes on the sheet:
BUS PIRATE V5
Ian Lesnet 2014
http://dangerousprototypes.com
SRAMS
IO BUFFER/GATE
BUS PIRATE I/O
BOOT MODE
PWR
MODE
VREG
PROGRAMMING HEADER
USB
INTERNAL 3.3V VREG
SWITCHED IO 3.3V
SWITCHED IO 5.0V
BUILT-IN LOGIC ANALYZER
ADC SENSE
USB INTERFACE
NORMAL
RESET
IO PULL UPS
LED INDICATORS
UART
SRAM UB/LB signal not needed!
Open Drain output H=Z, L=L
10 SRAM + IO_OE need to connect to FPGA and MCU
Some kind of FLASH (Winbond?) to store the FPGA bitstreams
connect to MCU hardware SPI so we can use DMA
FGPA to MCU hardware SPI Also to pin header for development programming
SS pulled low for slave config mode
CDONE=1 when configured. 10K pullup
CRESET=0=reset 10K pullup
VPP_FAST NC
GBIN/BUF = CLOCK; 0,2,4,6=RESET; 1,3,5,7=CLOCK ENABLE MCU clock out to GBIN FSMC (OE/WE/CE) to GBIN? MCU PWM to GBIN?
Add Vref (Vext)
DIR IO OD BP H H H H H L H L L IN H Z (input) L IN L L (open drain LOW) H X L :( (contention)
STM32 power rail
INTERNAL 1.2V VREG
SRAM_1
SRAM_2
LA_LAT_MISO -> BPIO_MISO

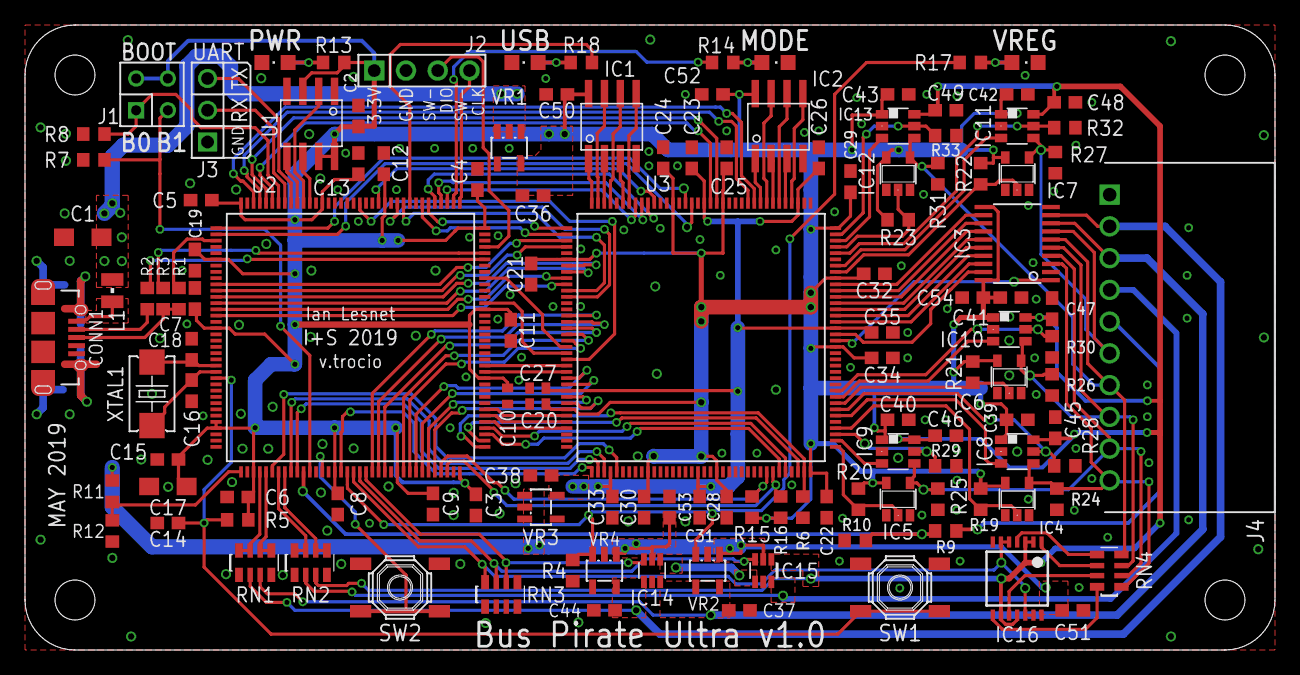
[picture p9: board BusPirate-ng.v4.0.brd from above]

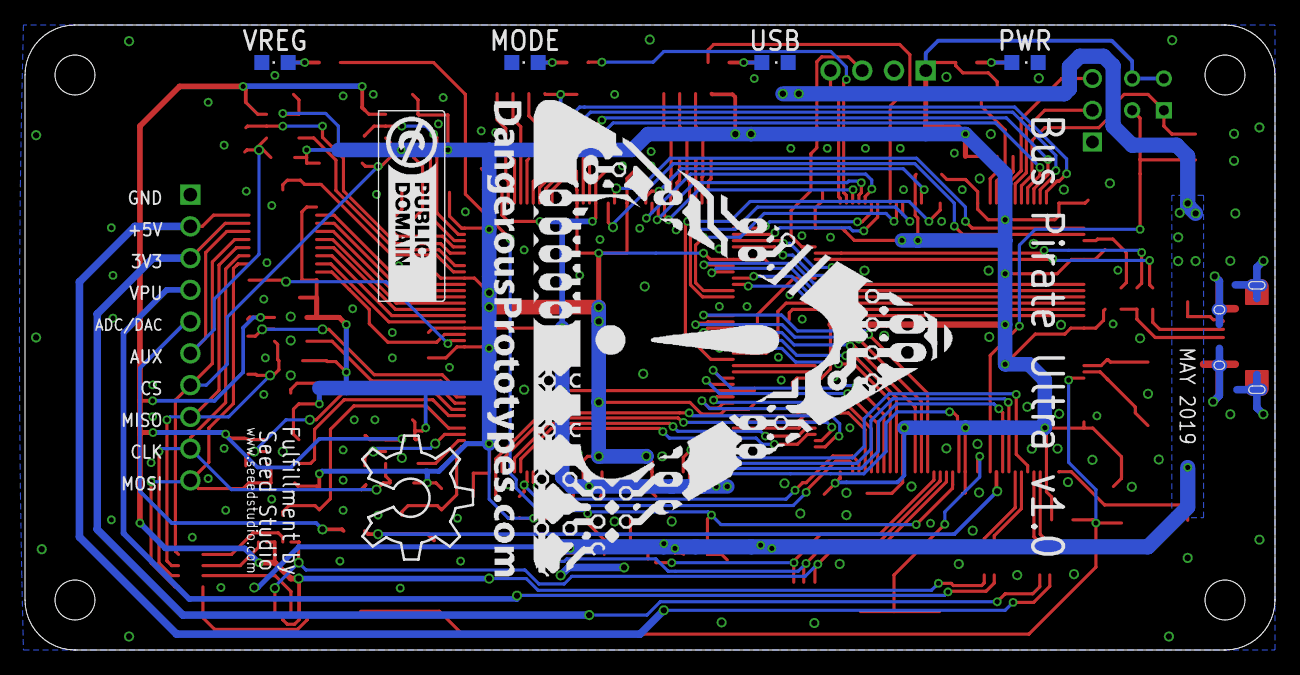
[picture p10: board BusPirate-ng.v4.0.brd from below]

Board: 2 copper layers, 100.0 x 50.0 mm, 136 parts (7 on the bottom side), 137 nets.

Other parts of the board:
U$1: DP-LOGO
U$2: OSHW_8X350_NOTEXT
U$4: DP_LOGO_ART_1.5X1.5
