DangerousPrototypes/Bus_Pirate_Ultra/source/LA.h

void LA_start(void);
uint32_t LA_send(uint32_t d);
uint32_t LA_read(void);
void LA_macro(uint32_t macro);
void LA_setup(void);
void LA_setup_exc(void);
void LA_cleanup(void);
void LA_pins(void);
void LA_settings(void);

//ians test functions
void logicAnalyzerSetup(void);
void logicAnalyzerCaptureStop(void);
void logicAnalyzerCaptureStart(void);
void logicAnalyzerDumpSamples(uint32_t numSamples);
void logicAnalyzerTest(void);

#define LATRIGGERMENU	"Trigger\r\n 1. Rising\r\n 2. Falling\r\n 3. Both\r\n 4. No trigger*\r\n> "
#define LAPERIODMENU 	"period> "
#define LASAMPLEMENU	"samples> "

#define CMDREAD		0x0B
#define CMDWRITE	0x02
#define CMDQUADMODE	0x35
#define CMDREADQUAD 0xEB
//#define CMDSEQLMODE	0xF5
#define CMDRESETSPI	0xF5
#define CMDWRITERREG	0x05

#define la_sram_mode_setup() gpio_set_mode(GPIOE,GPIO_MODE_OUTPUT_50_MHZ, GPIO_CNF_OUTPUT_PUSHPULL,GPIO2);
#define la_sram_mode_quad() gpio_set(GPIOE,GPIO2)
#define la_sram_mode_spi() gpio_clear(GPIOE,GPIO2)
#define la_sram_quad_setup() gpio_set_mode(GPIOE,GPIO_MODE_OUTPUT_50_MHZ, GPIO_CNF_OUTPUT_PUSHPULL,GPIO3);
#define la_sram_quad_output() gpio_set(GPIOE, GPIO3)
#define la_sram_quad_input() gpio_clear(GPIOE, GPIO3)

#define sram_enable() config_register|=(0b11000);FPGA_REG_03=config_register
#define sram_enable_0() config_register|=(0b01000);FPGA_REG_03=config_register
#define sram_enable_1() config_register|=(0b10000);FPGA_REG_03=config_register
#define sram_disable() config_register&=~(0b11000);FPGA_REG_03=config_register

#define sram_select() gpio_clear(BP_FPGA_CS_PORT,BP_FPGA_CS_PIN)
#define sram_deselect() gpio_set(BP_FPGA_CS_PORT,BP_FPGA_CS_PIN)

#define sram_clock_high() gpio_set(GPIOB,GPIO13)
#define sram_clock_low() gpio_clear(GPIOB,GPIO13)














#define BP_LA_SAMPLES_PER_CHANNEL (((BP_LA_SRAM_SIZE)*8)/4) //8 bits per byte, 4 channels per SRAM
#define BP_LA_OVERFLOW_COUNT (BP_LA_SAMPLES_PER_CHANNEL/(0xFFFF+1)) //divide by 16bit timer count

#define BP_LA_COUNTER_PRELOAD (0xFFFF-(0)) //preload the sample counter, can be used to avoid sampling overrun

#define BP_LA_LATCH_SETUP() gpio_set_mode(BP_LA_LATCH_PORT, GPIO_MODE_OUTPUT_50_MHZ, GPIO_CNF_OUTPUT_PUSHPULL, BP_LA_LATCH_PIN)
#define BP_LA_LATCH_OPEN() gpio_clear(BP_LA_LATCH_PORT, BP_LA_LATCH_PIN)
#define BP_LA_LATCH_CLOSE() gpio_set(BP_LA_LATCH_PORT, BP_LA_LATCH_PIN)

#define BP_LA_SRAM_CS_SETUP() gpio_set_mode(BP_LA_SRAM_CS_PORT, GPIO_MODE_OUTPUT_50_MHZ, GPIO_CNF_OUTPUT_PUSHPULL, BP_LA_SRAM_CS_PIN)
#define BP_LA_SRAM_DESELECT() gpio_set(BP_LA_SRAM_CS_PORT, BP_LA_SRAM_CS_PIN)
#define BP_LA_SRAM_SELECT() gpio_clear(BP_LA_SRAM_CS_PORT, BP_LA_SRAM_CS_PIN)

#define BP_LA_SRAM_CLOCK_SETUP() gpio_set_mode(BP_LA_SRAM_CLK_PORT, GPIO_MODE_OUTPUT_50_MHZ, GPIO_CNF_OUTPUT_PUSHPULL, BP_LA_SRAM_CLK_PIN);
#define BP_LA_SRAM_CLOCK_LOW() gpio_clear(BP_LA_SRAM_CLK_PORT, BP_LA_SRAM_CLK_PIN)
#define BP_LA_SRAM_CLOCK_HIGH() gpio_set(BP_LA_SRAM_CLK_PORT, BP_LA_SRAM_CLK_PIN)

#define BP_SRAM1_MOSI_PORT BP_LA_CHAN3_PORT
#define BP_SRAM1_MOSI_PIN BP_LA_CHAN3_PIN
#define BP_SRAM1_MISO_PORT BP_LA_CHAN2_PORT
#define BP_SRAM1_MISO_PIN BP_LA_CHAN2_PIN

#define BP_SRAM1_SIO0_PORT BP_LA_CHAN3_PORT
#define BP_SRAM1_SIO0_PIN BP_LA_CHAN3_PIN
#define BP_SRAM1_SIO1_PORT BP_LA_CHAN2_PORT
#define BP_SRAM1_SIO1_PIN BP_LA_CHAN2_PIN
#define BP_SRAM1_SIO2_PORT BP_LA_CHAN1_PORT
#define BP_SRAM1_SIO2_PIN BP_LA_CHAN1_PIN
#define BP_SRAM1_SIO3_PORT BP_LA_CHAN4_PORT
#define BP_SRAM1_SIO3_PIN BP_LA_CHAN4_PIN

#define BP_FPGA_SIO0_PORT GPIOB
#define BP_FPGA_SIO0_PIN GPIO15
#define BP_FPGA_SIO1_PORT GPIOB
#define BP_FPGA_SIO1_PIN GPIO14
#define BP_FPGA_SIO2_PORT GPIOF
#define BP_FPGA_SIO2_PIN GPIO0
#define BP_FPGA_SIO3_PORT GPIOF
#define BP_FPGA_SIO3_PIN GPIO1
