DangerousPrototypes/Bus_Pirate_Ultra/source/protocols.c

#include <stdint.h>
#include "cdcacm.h"
#include "buspirate.h"
#include "UI.h"
#include "protocols.h"

#include "HiZ.h"
#ifdef	BP_USE_1WIRE
    #include "1WIRE.h"
#endif
#ifdef	BP_USE_HWUSART
    #include "HWUSART.h"
#endif
#ifdef	BP_USE_HWI2C
    #include "HWI2C.h"
#endif
#ifdef	BP_USE_HWSPI
    #include "HWSPI.h"
#endif
#ifdef	BP_USE_SW2W
    #include "SW2W.h"
#endif
#ifdef	BP_USE_SW3W
    #include "SW3W.h"
#endif
#ifdef 	BP_USE_DIO
    #include "DIO.h"
#endif
#ifdef	BP_USE_LCDSPI
    #include "LCDSPI.h"
#endif
#ifdef	BP_USE_LCDI2C
    #include "LCDI2C.h"
#endif
#ifdef	BP_USE_LA
    #include "LA.h"
#endif
#ifdef 	BP_USE_DUMMY1
    #include "dummy1.h"
#endif
#ifdef 	BP_USE_DUMMY2
    #include "dummy2.h"
#endif


// nulfuncs
// these are the dummy functions when something ain't used

void nullfunc1(void)
{
	cdcprintf("ERROR: command has no effect here");
	modeConfig.error=1;
}

uint32_t nullfunc2(uint32_t c)
{
	(void) c;
	cdcprintf("ERROR: command has no effect here");
	modeConfig.error=1;
	return 0x0000;
}

uint32_t nullfunc3(void)
{
	cdcprintf("ERROR: command has no effect here");
	modeConfig.error=1;
	return 0x0000;
}

void nullfunc4(uint32_t c)
{
	(void) c;
	cdcprintf("ERROR: command has no effect here");
	modeConfig.error=1;
}

uint32_t nullfunc5(uint32_t c,uint32_t r,uint8_t b)
{
    (void) c;
	cdcprintf("ERROR: command has no effect here");
	modeConfig.error=1;
}

void nohelp(void)
{
	cdcprintf("No help available");
}

uint32_t noperiodic(void)
{
	return 0;
}

// all protocols and their interaction is handled here
// buspirateNG.h has the conditional defines for protocols

struct _protocol protocols[MAXPROTO]={
{
    //pre-process
	nullfunc1,				// start
	nullfunc1,				// start with read
	nullfunc1,				// stop
	nullfunc1,				// stop with read
	nullfunc5,				// send(/read) max 32 bit
	nullfunc5,				// read max 32 bit
	nullfunc1,				// set clk high
	nullfunc1,				// set clk low
	nullfunc1,				// set dat hi
	nullfunc1,				// set dat lo
	nullfunc3,				// toggle dat (?)
	nullfunc1,				// toggle clk (?)
	nullfunc3,				// read 1 bit (?)
	noperiodic,				// service to regular poll whether a byte ahs arrived
	nullfunc4,				// macro
	//post process
	nullfunc1,				// start
	nullfunc1,				// start with read
	nullfunc1,				// stop
	nullfunc1,				// stop with read
	nullfunc5,				// send(/read) max 32 bit
	nullfunc5,				// read max 32 bit
	nullfunc1,				// set clk high
	nullfunc1,				// set clk low
	nullfunc1,				// set dat hi
	nullfunc1,				// set dat lo
	nullfunc3,				// toggle dat (?)
	nullfunc1,				// toggle clk (?)
	nullfunc3,				// read 1 bit (?)
	noperiodic,				// service to regular poll whether a byte ahs arrived
	nullfunc4,				// macro
	//non-pipelined commands
	HiZsetup,				// setup UI
	HiZsetup_exc,				// real setup
	HiZcleanup,				// cleanup for HiZ
	HiZpins,				// display pin config
	HiZsettings,				// display settings
	nohelp,					// display small help about the protocol
	"HiZ",					// friendly name (promptname)
},
#ifdef BP_USE_1WIRE
{
    ONEWIRE_start,				// start
    ONEWIRE_startr,				// start with read
    ONEWIRE_stop,				// stop
    ONEWIRE_stopr,				// stop with read
    ONEWIRE_send,				// send(/read) max 32 bit
    ONEWIRE_read,				// read max 32 bit
    ONEWIRE_clkh,				// set clk high
    ONEWIRE_clkl,				// set clk low
    ONEWIRE_dath,				// set dat hi
    ONEWIRE_datl,				// set dat lo
    ONEWIRE_dats,				// toggle dat (?)
    ONEWIRE_clk,				// toggle clk (?)
    ONEWIRE_bitr,				// read 1 bit (?)
    ONEWIRE_period,				// service to regular poll whether a byte ahs arrived
    ONEWIRE_macro,				// macro
    ONEWIRE_setup,				// setup UI
    ONEWIRE_setup_exc,			// real setup
    ONEWIRE_cleanup,			// cleanup for HiZ
    ONEWIRE_pins,				// display pin config
    ONEWIRE_settings,			// display settings
    nohelp,					// display small help about the protocol
    "1-WIRE",				// friendly name (promptname)
},
#endif
#ifdef BP_USE_HWUSART
{
    nullfunc1,				// start
    nullfunc1,				// start with read
    nullfunc1,				// stop
    nullfunc1,				// stop with read
    HWUSART_send,				// send(/read) max 32 bit
    HWUSART_read,				// read max 32 bit
    nullfunc1,				// set clk high
    nullfunc1,				// set clk low
    nullfunc1,				// set dat hi
    nullfunc1,				// set dat lo
    nullfunc3,				// toggle dat (?)
    nullfunc1,				// toggle clk (?)
    nullfunc3,				// read 1 bit (?)
    noperiodic,				// service to regular poll whether a byte ahs arrived
    HWUSART_macro,				// macro
    HWUSART_setup,				// setup UI
    HWUSART_setup_exc,			// real setup
    HWUSART_cleanup,			// cleanup for HiZ
    HWUSART_pins,				// display pin config
    HWUSART_settings,			// display settings
    HWUSART_help,				// display small help about the protocol
    "UART",				// friendly name (promptname)
},
#endif
#ifdef BP_USE_HWI2C
{
    HWI2C_start,				// start
    HWI2C_start,				// start with read
    HWI2C_stop,				// stop
    HWI2C_stop,				// stop with read
    HWI2C_send,				// send(/read) max 32 bit
    HWI2C_read,				// read max 32 bit
    nullfunc1,				// set clk high
    nullfunc1,				// set clk low
    nullfunc1,				// set dat hi
    nullfunc1,				// set dat lo
    nullfunc3,				// toggle dat (?)
    nullfunc1,				// toggle clk (?)
    nullfunc3,				// read 1 bit (?)
    noperiodic,				// service to regular poll whether a byte ahs arrived
    HWI2C_macro,				// macro
    HWI2C_setup,				// setup UI
    HWI2C_setup_exc,			// real setup
    HWI2C_cleanup,				// cleanup for HiZ
    HWI2C_pins,				// display pin config
    HWI2C_settings,				// display settings
    HWI2C_help,				// display small help about the protocol
    "I2C",				// friendly name (promptname)
},
#endif
#ifdef BP_USE_HWSPI
{
    //pre-process
	HWSPI_start,				// start
	HWSPI_startr,				// start with read
	HWSPI_stop,				// stop
	HWSPI_stopr,				// stop with read
	HWSPI_send,				// send(/read) max 32 bit
	HWSPI_send,				// read max 32 bit
	nullfunc1,				// set clk high
	nullfunc1,				// set clk low
	nullfunc1,				// set dat hi
	nullfunc1,				// set dat lo
	nullfunc3,				// toggle dat (?)
	nullfunc1,				// toggle clk (?)
	nullfunc3,				// read 1 bit (?)
	noperiodic,				// service to regular poll whether a byte ahs arrived
	HWSPI_macro,				// macro
	//post-process
    HWSPI_start_post,				// start
	HWSPI_startr_post,				// start with read
	HWSPI_stop_post,				// stop
	HWSPI_stopr_post,				// stop with read
	HWSPI_send_post,				// send(/read) max 32 bit
	HWSPI_read_post,				// read max 32 bit
	nullfunc1,				// set clk high
	nullfunc1,				// set clk low
	nullfunc1,				// set dat hi
	nullfunc1,				// set dat lo
	nullfunc3,				// toggle dat (?)
	nullfunc1,				// toggle clk (?)
	nullfunc3,				// read 1 bit (?)
	noperiodic,				// service to regular poll whether a byte ahs arrived
	HWSPI_macro_post,				// macro
	//non-pipelined
	HWSPI_setup,				// setup UI
	HWSPI_setup_exc,			// real setup
	HWSPI_cleanup,				// cleanup for HiZ
	HWSPI_pins,				// display pin config
	HWSPI_settings,				// display settings
	HWSPI_help,				// display small help about the protocol
	"SPI",				// friendly name (promptname)
},
#endif
#ifdef BP_USE_SW2W
{
	SW2W_start,				// start
	SW2W_startr,				// start with read
	SW2W_stop,				// stop
	SW2W_stopr,				// stop with read
	SW2W_send,				// send(/read) max 32 bit
	SW2W_read,				// read max 32 bit
	SW2W_clkh,				// set clk high
	SW2W_clkl,				// set clk low
	SW2W_dath,				// set dat hi
	SW2W_datl,				// set dat lo
	SW2W_dats,				// toggle dat (?)
	SW2W_clk,				// toggle clk (?)
	SW2W_bitr,				// read 1 bit (?)
	noperiodic,				// service to regular poll whether a byte ahs arrived
	SW2W_macro,				// macro
	SW2W_setup,				// setup UI
	SW2W_setup_exc,				// real setup
	SW2W_cleanup,				// cleanup for HiZ
	SW2W_pins,				// display pin config
	SW2W_settings,				// display settings
	nohelp,					// display small help about the protocol
	"2WIRE",					// friendly name (promptname)
},
#endif
#ifdef BP_USE_SW3W
{
	SW3W_start,				// start
	SW3W_startr,				// start with read
	SW3W_stop,				// stop
	SW3W_stopr,				// stop with read
	SW3W_send,				// send(/read) max 32 bit
	SW3W_read,				// read max 32 bit
	SW3W_clkh,				// set clk high
	SW3W_clkl,				// set clk low
	SW3W_dath,				// set dat hi
	SW3W_datl,				// set dat lo
	SW3W_dats,				// toggle dat (?)
	SW3W_clk,				// toggle clk (?)
	SW3W_bitr,				// read 1 bit (?)
	noperiodic,				// service to regular poll whether a byte ahs arrived
	SW3W_macro,				// macro
	SW3W_setup,				// setup UI
	SW3W_setup_exc,				// real setup
	SW3W_cleanup,				// cleanup for HiZ
	SW3W_pins,				// display pin config
	SW3W_settings,				// display settings
	SW3W_help,				// display small help about the protocol
	"3WIRE",					// friendly name (promptname)
},
#endif
#ifdef BP_USE_LCDSPI
{
	nullfunc1,				// start
	nullfunc1,				// start with read
	nullfunc1,				// stop
	nullfunc1,				// stop with read
	LCDSPI_send,				// send(/read) max 32 bit
	LCDSPI_read,				// read max 32 bit
	nullfunc1,				// set clk high
	nullfunc1,				// set clk low
	nullfunc1,				// set dat hi
	nullfunc1,				// set dat lo
	nullfunc3,				// toggle dat (?)
	nullfunc1,				// toggle clk (?)
	nullfunc3,				// read 1 bit (?)
	noperiodic,				// service to regular poll whether a byte ahs arrived
	LCDSPI_macro,				// macro
	LCDSPI_setup,				// setup UI
	LCDSPI_setup_exc,			// real setup
	LCDSPI_cleanup,				// cleanup for HiZ
	LCDSPI_pins,				// display pin config
	LCDSPI_settings,			// display settings
	nohelp,					// display small help about the protocol
	"LCDSPI",				// friendly name (promptname)
},
#endif
#ifdef BP_USE_LCDI2C
{
	nullfunc1,				// start
	nullfunc1,				// start with read
	nullfunc1,				// stop
	nullfunc1,				// stop with read
	LCDI2C_send,				// send(/read) max 32 bit
	LCDI2C_read,				// read max 32 bit
	nullfunc1,				// set clk high
	nullfunc1,				// set clk low
	nullfunc1,				// set dat hi
	nullfunc1,				// set dat lo
	nullfunc3,				// toggle dat (?)
	nullfunc1,				// toggle clk (?)
	nullfunc3,				// read 1 bit (?)
	noperiodic,				// service to regular poll whether a byte ahs arrived
	LCDI2C_macro,				// macro
	LCDI2C_setup,				// setup UI
	LCDI2C_setup_exc,			// real setup
	LCDI2C_cleanup,				// cleanup for HiZ
	LCDI2C_pins,				// display pin config
	LCDI2C_settings,			// display settings
	nohelp,					// display small help about the protocol
	"LCDI2C",				// friendly name (promptname)
},
#endif
#ifdef BP_USE_DIO
{
    nullfunc1,				// start
    nullfunc1,				// start with read
    nullfunc1,				// stop
    nullfunc1,				// stop with read
    DIO_send,				// send(/read) max 32 bit
    DIO_read,				// read max 32 bit
    nullfunc1,				// set clk high
    nullfunc1,				// set clk low
    nullfunc1,				// set dat hi
    nullfunc1,				// set dat lo
    nullfunc3,				// toggle dat (?)
    nullfunc1,				// toggle clk (?)
    nullfunc3,				// read 1 bit (?)
    noperiodic,				// service to regular poll whether a byte ahs arrived
    DIO_macro,				// macro
    DIO_setup,				// setup UI
    DIO_setup_exc,				// real setup
    DIO_cleanup,				// cleanup for HiZ
    DIO_pins,				// display pin config
    DIO_settings,				// display settings
    DIO_help,				// display small help about the protocol
    "DIO",					// friendly name (promptname)
},
#endif
#ifdef BP_USE_LA
{
    nullfunc1,				// start
    nullfunc1,				// start with read
    nullfunc1,				// stop
    nullfunc1,				// stop with read
    nullfunc2,				// send(/read) max 32 bit
    nullfunc3,				// read max 32 bit
    nullfunc1,				// set clk high
    nullfunc1,				// set clk low
    nullfunc1,				// set dat hi
    nullfunc1,				// set dat lo
    nullfunc3,				// toggle dat (?)
    nullfunc1,				// toggle clk (?)
    nullfunc3,				// read 1 bit (?)
    noperiodic,				// service to regular poll whether a byte ahs arrived
    LA_macro,				// macro
    LA_setup,				// setup UI
    LA_setup_exc,				// real setup
    LA_cleanup,				// cleanup for HiZ
    LA_pins,				// display pin config
    LA_settings,				// display settings
    nohelp,					// display small help about the protocol
    "LA",					// friendly name (promptname)
},
#endif
#ifdef BP_USE_DUMMY1
{
    dummy1_start,				// start
    dummy1_startr,				// start with read
    dummy1_stop,				// stop
    dummy1_stopr,				// stop with read
    dummy1_send,				// send(/read) max 32 bit
    dummy1_read,				// read max 32 bit
    dummy1_clkh,				// set clk high
    dummy1_clkl,				// set clk low
    dummy1_dath,				// set dat hi
    dummy1_datl,				// set dat lo
    dummy1_dats,				// toggle dat (?)
    dummy1_clk,				// toggle clk (?)
    dummy1_bitr,				// read 1 bit (?)
    dummy1_period,				// service to regular poll whether a byte ahs arrived
    dummy1_macro,				// macro
    dummy1_setup,				// setup UI
    dummy1_setup_exc,			// real setup
    dummy1_cleanup,				// cleanup for HiZ
    dummy1_pins,				// display pin config
    dummy1_settings,			// display settings
    nohelp,					// display small help about the protocol
    "DUMMY1",				// friendly name (promptname)
},
#endif
#ifdef BP_USE_DUMMY2
{
    dummy2_start,				// start
    dummy2_startr,				// start with read
    dummy2_stop,				// stop
    dummy2_stopr,				// stop with read
    dummy2_send,				// send(/read) max 32 bit
    dummy2_read,				// read max 32 bit
    dummy2_clkh,				// set clk high
    dummy2_clkl,				// set clk low
    dummy2_dath,				// set dat hi
    dummy2_datl,				// set dat lo
    dummy2_dats,				// toggle dat (?)
    dummy2_clk,				// toggle clk (?)
    dummy2_bitr,				// read 1 bit (?)
    dummy2_period,				// service to regular poll whether a byte ahs arrived
    dummy2_macro,				// macro
    dummy2_setup,				// setup UI
    dummy2_setup_exc,			// real setup
    dummy2_cleanup,				// cleanup for HiZ
    dummy2_pins,				// display pin config
    dummy2_settings,			// display settings
    nohelp,					// display small help about the protocol
    "DUMMY2",				// friendly name (promptname)
},
#endif

};
