DangerousPrototypes/Bus_Pirate_Ultra/source/HiZ.c

#include <stdint.h>
#include <libopencm3/stm32/gpio.h>
#include "buspirate.h"
#include "HiZ.h"
#include "cdcacm.h"
#include "UI.h"
#include "AUXpin.h"
#include "lcd.h"
#include "PSU.h"



void HiZpins(void)
{
	cdcprintf("-\t-\t-\t-");
}

void HiZsettings(void)
{
	cdcprintf("HiZ ()=()");
}


void HiZcleanup(void)
{
}

void HiZsetup(void)
{
}

// this is called duringmode changes; takes care pwm, vpu and psu is turned off, also AUX to input
void HiZsetup_exc(void)
{
	// turn everything off
	modeConfig.psu=0;
	psuDisable();
	modeConfig.pullups=0;
	gpio_clear(BP_VPUEN_PORT, BP_VPUEN_PIN);

	// aux and pwm
	(void)getAUX();
	setPWM(0, 0);

	// allow postphoned inits
	modeConfig.init=0;
	const char pinLabels[]="HiZ\0HiZ\0HiZ\0HiZ\0HiZ\0HiZ\0HiZ\0HiZ\0";

	modeLabelsSetupLCD(pinLabels);

}
