DangerousPrototypes/Bus_Pirate_Ultra/source/HWSPI.h

//preprocess
void HWSPI_start(void);
void HWSPI_startr(void);
void HWSPI_stop(void);
void HWSPI_stopr(void);
uint32_t HWSPI_send(uint32_t d,uint32_t r,uint8_t b);
uint32_t HWSPI_read(uint32_t d,uint32_t r,uint8_t b);
void HWSPI_macro(uint32_t macro);
//post process
void HWSPI_start_post(void);
void HWSPI_startr_post(void);
void HWSPI_stop_post(void);
void HWSPI_stopr_post(void);
uint32_t HWSPI_send_post(uint32_t d,uint32_t r,uint8_t b);
uint32_t HWSPI_read_post(uint32_t d,uint32_t r,uint8_t b);
void HWSPI_macro_post(uint32_t macro);

//non-pipelined commands
void HWSPI_setup(void);
void HWSPI_setup_exc(void);
void HWSPI_cleanup(void);
void HWSPI_pins(void);
void HWSPI_settings(void);
void HWSPI_printSPIflags(void);
void HWSPI_help(void);

// special for binmode and lcd
void HWSPI_setcpol(uint32_t val);
void HWSPI_setcpha(uint32_t val);
void HWSPI_setbr(uint32_t val);
void HWSPI_setdff(uint32_t val);
void HWSPI_setlsbfirst(uint32_t val);
void HWSPI_setcsidle(uint32_t val);
void HWSPI_setcs(uint8_t cs);
uint16_t HWSPI_xfer(uint16_t d);

// menus
#define SPISPEEDMENU	"\r\nSPI Clock speed\r\n 1. 18Mhz\r\n 2.  9Mhz\r\n 3. 4.5Mhz\r\n 4. 2Mhz\r\n 5. 1Mhz\r\n 6. 560khz\r\n 7. 280Khz\r\n 8. 140Khz*\r\nspeed> "
#define SPICPOLMENU	"\r\nClock polarity\r\n 1. idle low*\r\n 2. idle high\r\ncpol> "
#define SPICPHAMENU	"\r\nClock phase\r\n 1. leading edge\r\n 2. trailing edge*\r\ncpha> "
#define SPICSIDLEMENU	"\r\nCS mode\r\n 1. CS\r\n 2. !CS*\r\ncs> "
#define SPIODMENU	"\r\nOpen drain mode\r\n 1. Pushpull\r\n 2. Opendrain*\r\nod> "
