DangerousPrototypes/Bus_Pirate_Ultra/hdl/buspirate/spifacade.v

//thoughts:
//0x00XX = data to spi
//0x01XX = [
//0x02XX = ]

`ifndef __facade__
`define __facade__
module facade #(
    parameter BP_PINS = 5
  )(
    input wire clock,
    input wire reset,
    //input wire [15:0] configuration_register,
    input wire [7:0] in_data,
    output wire [7:0] out_data,
    //out_data,
    input wire go,
    output wire state,
    output wire data_ready,
    // pins (directions???)
    output wire [BP_PINS-1:0] bp_din,
    input wire [BP_PINS-1:0] bp_dout

  );

  // SPI master
  // sync signals
  reg state_last;
  assign data_ready=((state_last===1'b1)&&(state===1'b0));

  spimaster SPI_MASTER(
  // general control
    .rst(reset),				// resets module to known state
    .clkin(clock),				// clock that makes everyhting tick
  // spi configuration
    .cpol(1'b1), //cpol,				// clock polarity
    .cpha(1'b0), //cpha,				// clock phase
    .cspol(1'b1), //cspol,				// CS polarity
    .autocs(1'b1), //autocs,				// assert CS automatically
  // sync signals
    .go(go),					// starts a SPI transmission
    .state(state),				// state of module (0=idle, 1=busy/transmitting)
  // data in/out
    .data_i(in_data), 			// data in (will get transmitted)
    .data_o(out_data),				// data out (will get received)
  // spi signals
    .mosi(bp_din[0]),             // master out slave in
    .sclk(bp_din[1]),             // SPI clock (= clkin/2)
    .miso(bp_dout[2]),         // master in slave out
    .cs(bp_din[3])				      // chip select
    );

    always @(posedge clock)
    begin
      state_last<=state;
    end
endmodule

`endif
