DangerousPrototypes/Bus_Pirate_Ultra/hdl/buspirate/fifo.v

/*
 *  IcoProg -- Programmer and Debug Tool for the IcoBoard
 *
 *  Copyright (C) 2016  Clifford Wolf <clifford@clifford.at>
 *
 *  Permission to use, copy, modify, and/or distribute this software for any
 *  purpose with or without fee is hereby granted, provided that the above
 *  copyright notice and this permission notice appear in all copies.
 *
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
 */
 //https://github.com/cliffordwolf/icotools/blob/master/icosoc/common/icosoc_crossclkfifo.v
`ifndef __FIFO__
`define __FIFO__
module fifo #(
	parameter WIDTH = 16,
	parameter DEPTH = 4
) (
	input                  in_clock,
	input                  in_shift,
	input      [WIDTH-1:0] in_data,
	output reg             in_full,
	output reg             in_nempty,

	input 								out_clock,
	input                  out_pop,
	output     [WIDTH-1:0] out_data,
	output reg             out_nempty
);
	localparam integer ABITS = $clog2(DEPTH);

	initial begin
		in_full = 0;
		in_nempty = 0;
		out_nempty = 0;
	end

	reg [ABITS-1:0] in_pos = 0;
	reg [ABITS-1:0] out_pos = 0;

	reg [WIDTH-1:0] memory [0:DEPTH-1];

	wire [ABITS-1:0] next_in_pos = (in_pos == DEPTH-1) ? 0 : in_pos + 1;
	wire [ABITS-1:0] next_next_in_pos = (next_in_pos == DEPTH-1) ? 0 : next_in_pos + 1;

	wire [ABITS-1:0] next_out_pos = (out_pos == DEPTH-1) ? 0 : out_pos + 1;
	reg [WIDTH-1:0] out_data_d = 0;

	always @(posedge in_clock) begin
		if (in_shift && !in_full) begin
			memory[in_pos] <= in_data;
			in_full <= (next_next_in_pos == out_pos);
			in_nempty <= 1;
			in_pos <= next_in_pos;
		end else begin
			in_full <= (next_in_pos == out_pos);
			in_nempty <= (in_pos != out_pos);
		end
	end

	always @(posedge out_clock) begin
		if (out_pop && out_nempty) begin
			out_data_d <= memory[out_pos];
			out_nempty <= (next_out_pos != in_pos);
			out_pos <= next_out_pos;
		end else begin
			//out_data_d <= memory[out_pos];
			out_nempty <= (out_pos != in_pos);
		end

	end

	assign out_data =  out_data_d;



endmodule
`endif
