DangerousPrototypes/Bus_Pirate_Ultra/(commit log)

2019-04-27 Updated STM32 footprint
2019-04-29 Commit EAGLE files instead of zips, Route supply on FPGA SPI module, route FPGA SPI to STM32
    [BusPirate-ng.v4.0.brd, BusPirate-ng.v4.0.sch]
2019-04-30 connect ARM chip's FSMC address, data and control pins except CS to FPGA
    [BusPirate-ng.v4.0.brd, BusPirate-ng.v4.0.sch]
2019-04-30 connect power 1.2V and 3.3V for bank 2 and 3 of FPGA
    [BusPirate-ng.v4.0.brd, BusPirate-ng.v4.0.sch]
2019-05-02 wired -BOOT0 and BOOT1 to corresponding switches -NRST to reset switch -VBAT with 0.1uF cap to 3V3 -VDDA with 0.1uF and 1uF cap to 3V3 -VSSA to GND -PC0 - PC4 to ADC2 - AD6 -control pins pull ups VEX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
    added connection but not wired yet to FPGA
    -FSMC_D8 to D15
    [BusPirate-ng.v4.0.brd, BusPirate-ng.v4.0.sch]
2019-05-02 removed connection FSMC_NOE_OE and FSMC_NEW_WE wired FSMC_D8 - FSMC_D15 to FPGA
    [BusPirate-ng.v4.0.brd, BusPirate-ng.v4.0.sch]
2019-05-06 wired: -IO headers -CRESET -CDONE -MCU_MCO (Master Clock Out) to FPGA -FPGA to IO buffers -VCCPLL with 0.1uF cap and GNDPLL -2 interrupts from FPGA but not yet connected
    [BusPirate-ng.v4.0.brd, BusPirate-ng.v4.0.sch]
2019-05-07 wired Logic analyzer circuit to FPGA
    [BusPirate-ng.v4.0.brd, BusPirate-ng.v4.0.sch]
2019-05-08 routing started, switch to bigger DP8556 PCB
    [BusPirate-ng.v4.0.brd, BusPirate-ng.v4.0.sch]
2019-05-09 individualy wired SRAM to FPGA and LATCH to FPGA, continue routing
    [BusPirate-ng.v4.0.brd, BusPirate-ng.v4.0.sch]
2019-05-09 move: UART_TX and UART_RX from PA9/PA10 USART1(0) to PA6/PA7 USART1(1) VREGEN from PB6 to PE1 LD1 to PD2 USBLED to PD3 V50PU from PB4 to PG0 V33PU from PB5 to PG1 USB_DET from PA15 to PF11 VEXTPU fro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
    [BusPirate-ng.v4.0.brd, BusPirate-ng.v4.0.sch]
2019-05-10 moved SRAM_CS from PB3 to PA15 reconnect BPIO_MOSI, BPIO_CLOCK, BPIO_MISO, BPIO_CS, BPIO_AUX to latch's data pins, these we're accidentally disconnected on the last update removed connection of AUX0 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
    [BusPirate-ng.v4.0.brd, BusPirate-ng.v4.0.sch]
2019-05-11 move ADC5 from PC0 to PA3 move ADC4 from PC2 to PC4 move ADC3 from PC1 to PC5 move AD6 to PC4 move latch's IO_OE from FPGA pin IOT_206 to IOT_177 remove connection of logic analyzer's 2 SRAM CS from 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
    [BusPirate-ng.v4.0.brd, BusPirate-ng.v4.0.sch]
2019-05-15 moved BUFDIR_MOSI from IOR_167 to IOR_111 BUFIO_MOSI from IOR_166 to IOR_110 BUFOD_MOSI from IOR_165 to IOR_119 BUFDIR_CLOCK from 164 to IOR_115 BUFIO_CLOCK from 161 to IOR_114 BUFOD_CLOCK from 160 t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
    [BusPirate-ng.v4.0.brd, BusPirate-ng.v4.0.sch]
2019-05-15 moved LA_LAT_SWV50 from IOT_168 (bank-0) to IOR_152 LA_LAT_SWV33 from IOT_169 to IOR_148 LA_LAT_AUX0 from IOT_170 to IOR_147 LA_LAT_CS from IOT_171 to IOR_146 LA_LAT_MISO from IOT_172 to IOR_144 LA_L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
    [BusPirate-ng.v4.0.brd, BusPirate-ng.v4.0.sch]
2019-05-16 convert switched 5V and 3.3V voltage divider resistors R9, R10, R11, R12 to resistor array moved ADC4 from PC4 (ADC12_IN14) to PA4 (ADC12_IN4) ADC3 from PC5 (ADC12_IN15) to PA5 (ADC12_IN5) ADC2 from 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
    [BusPirate-ng.v4.0.brd, BusPirate-ng.v4.0.sch]
2019-05-16 added verilog test bench with clock. Added a simulation of the physical buffer chips to easily spot the pin output state and also detect bus contention in simulation.
2019-05-16 buspirate_development.pcf with pinout for current development hardware
2019-05-16 added 0.1uF decoupling caps on both power pins of 74LVC buffer chips move latch's IO_OE from FPGA's IOR_139 pin to IOR_138 move LA_MEM_AUX0 from IOT_212 to IOT_169 move LA_MEM_SWV50 from IOT_213 to I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
    [BusPirate-ng.v4.0.brd, BusPirate-ng.v4.0.sch]
2019-05-17 Renamed nets name and wire missing connection -renamed SRAM nets -renamed LATCH nets -wired FSMC control pins. FSMC_NOE_OE, FSMC_NWE_WE and FSMC_NE3_CE to FPGA 11, 12 and 22. -wired PWM pin PC6 (TIM8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
    [BusPirate-ng.v4.0.brd, BusPirate-ng.v4.0.sch]
2019-05-20 Continued routing, swapped some pins on FPGA swapped FPGA pins: BUFOD_CLOCK with BUFOD_MOSI BUFIO_CLOCK with BUFIO_MOSI BUFDIR_CLOCK with BUFDIR_MOSI BUFDIR_AUX with BUFDIR_CS BUFIO_AUX with BUFIO_CS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
    [BusPirate-ng.v4.0.brd, BusPirate-ng.v4.0.sch]
2019-05-20 add IRQ pins to buspirate.v; bitstream header documentation and sample hex
    [bitstream-header.xls]
2019-05-21 rework bus pirate verilog to use pwm module. in progress
    [buspirate.v, buspirate_tb.v, iobuf_tb.v, iobufphy.v]
2019-05-21 pwm added to bus pirate module. simulates, but there is an issue with the fake buffer (phy)
    [buspirate.v, buspirate_tb.v]
2019-05-21 move some pins, wire vrefs, change caps size and continue routing -wire vref+ and vref- to 3.3V and GND -wired MCU_INT0 to PE2 and MCU_INT1 to PE3, to have each pin a dedicated interrupt. -change cap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
    [BusPirate-ng.v4.0.brd, BusPirate-ng.v4.0.sch]
2019-05-22 moving some pins and continue routing -move VREGEN from MCU pin PE1 to PD2 -move LD1 from MCU PD2 to PA15
    [BusPirate-ng.v4.0.brd, BusPirate-ng.v4.0.sch]
2019-05-22 fix comparison operator in verilog fake buffer for simulation
    [buspirate.v, buspirate_tb.v, iobufphy.v]
2019-05-23 route power traces
    [BusPirate-ng.v4.0.brd]
2019-05-23 simulation of memory controller interface. 0x19 writes to the PWM (50% duty fixed). had to make the data pins input only and remove the SB_IO instantiation, this needs further investigation.
    [buspirate.v, buspirate_tb.v]
2019-05-23 change address decoder to case statement
2019-05-23 continue routing power traces
    [BusPirate-ng.v4.0.brd]
2019-05-24 spi master directly connected to 0x00 write address. all BPIO pins and buffers now connected and have been simulated.
2019-05-24 simplified fifo, still several major issues
    [buspirate.v, buspirate_tb.v, fifo.v]
2019-05-24 connect remaining loose nets, finished routing -connect VCC of 74LVCT45 to pull-up voltage VPUN -connect pull-up resistors of FPGA_CRESET and FPGA_CDONE to to 3V3
    [BusPirate-ng.v4.0.brd, BusPirate-ng.v4.0.sch]
2019-05-24 fix board labels
    [BusPirate-ng.v4.0.brd]
2019-05-24 renumber parts
    [BusPirate-ng.v4.0.brd, BusPirate-ng.v4.0.sch]
2019-05-25 buspirate module fix move bytes from MC to FIFO to SPI!
    [buspirate.v]
2019-05-25 clock divider, pwm, and spi modules from SMDprutser
2019-05-25 frequency counter and state machine from SMDprutser
    [bitstream-header.xls]
2019-05-25 added output FIFO and attached to SPI
2019-05-26 read/write FIFO. in fifo seems to be 100% working. out fifo just has some bidirectional config issues.
    [buspirate.v]
2019-05-26 cleanup old variables. fix == vs === assignments. add initial values.
    [buspirate.v]
2019-05-26 Add read test. fix bug in synchronizer.
    [buspirate_tb.v]
2019-05-26 fix OUT FIFO shift and pop logic
    [buspirate.v]
2019-05-27 convert pwm to nonblocking. fixes problem inferring BRAM (maybe? ned to check on build server)
2019-05-27 another test... BRAM not working still, but compile time is down to seconds with the change to PWM logic
    [fifo.v]
2019-05-28 replaced USB mini-B connector, fix DRC errors on the said connector
    [BusPirate-ng.v4.0.brd, BusPirate-ng.v4.0.sch]
2019-05-28 added test board
    [BusPirate-ultra-testboard.v1.0.brd, BusPirate-ultra-testboard.v1.0.sch]
2019-05-29 updated BP test board board, added LEDs for 5V and 3.3V
    [BusPirate-ultra-testboard.v1.0.brd, BusPirate-ultra-testboard.v1.0.sch]
2019-06-01 seperated fifo clocks, makes a lot more sense. reduced the number of states in the dispatch state machine. Fixed the "needs an extra clock" bug in dispatch FIFO pop. How should that be written? NAEC?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
    [buspirate.v, dispatch.v, fifo.v]
2019-06-01 spi out and aux commands working
2019-06-02 Auxillary connection from MCU to FPGA -MCU_AUX1 FPGA_137 -> PC10 -MCU_AUX2 FPGA_136 -> PC11 -MCU_AUX3 FPGA_135 -> PC12 -MCU_AUX4 FPGA_134 -> PD6 -MCU_AUX5 FPGA_125 -> PB8 -MCU_AUX6 FPGA_124 -> PB9 -M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
    gave SRAM each FPGA clock pins, SRAM0_CLOCK and SRAM1_CLOCK
    -moved around SRAM1's pins of FPGA
    -SRAM1_CS from FPGA_116 to FPGA_117
    -SRAM1_SIO3 from FPGA_115 to FPGA_116
    -SRAM_SIO1 from FPGA_114 to FPGA_115
    -new FPGA pin SRAM1_CLOCK to FPGA_114
    [BusPirate-ng.v4.0.brd, BusPirate-ng.v4.0.sch]
2019-06-03 added new aux pins connecting MCU to FPGA, created gerbers for BP ultra and BP ultra testboard
    Moved pins to make way for AUX pins connection
    -swapped MCU pins PB10(FPGA_CRESET) and PB11(FPGA_CDONE)
    -moved VREGEN from MCU pin PD2 to PF14
    New aux pins connecting MCU to FPGA
    -MCU_AUX9 FPGA_37 PF13
    -MCU_AUX10 FPGA_38 PB0
    -MCU_AUX11 FPGA_39 PC5
    -MCU_AUX12 FPGA_41 PA6
    [BusPirate-ng.v4.0.brd, BusPirate-ng.v4.0.sch]
2019-06-03 updated with latest SRAM connections. added some tests of SRAM handling. TODO: latch handling and switching.
2019-06-05 replaced U1 flash chip of BP ultra to W25X40CL type, still an SO-8 footprint
    [BusPirate-ng.v4.0.brd, BusPirate-ng.v4.0.sch]
2019-07-04 initial code for arm side of things.
    mostly reused from the nextgen codebase
2019-07-08 update PCF for current hardware. Cleanup iobuffer example for initial blinken test
2019-07-08 added new schematic for new pull up voltage regulator and ADC circuit
    [BusPirate-ultra-proto-pwr_adc.v.0.sch]
2019-07-08 initial ADC circuit added
    [BusPirate-ultra-proto-pwr_adc.v.0.sch]
2019-07-09 added proto board for BP ultra's adj vreg
    [BusPirate-ultra-proto-adj_vreg.v.0.brd, BusPirate-ultra-proto-adj_vreg.v.0.sch]
2019-07-09 changed vreg and pass mosfet
    [BusPirate-ultra-proto-adj_vreg.v.0.brd, BusPirate-ultra-proto-adj_vreg.v.0.sch]
2019-07-11 - some testing on fsmc side and sram interaction (not working as expected yet) - selftest abused for loading fpga bitstream and reading/writing to fpga
    [UI.c, fpga.c, fpga.h]
2019-07-12 flipped IO connector
    [BusPirate-ultra-testboard.v1.0.brd]
2019-07-14 bus pirate firmware updates with bitstream loader on CDC2, fix for FSMC
    [UI.c, beta1.h, buspirate.c]
2019-07-25 enable both SRAMs, read and write from SPI and write to quad
2019-07-31 currently working SRAMs using fsmc clock
2019-08-02 debugging possible hardware failure
    [LA.c, LA.h, buspirate.c, fpga.h]
2019-08-05 fixed timing issue with sram clock pulse. adjusted and tested FSMC timing. Thanks to Sjaak for loaning the Open Logic Sniffer, the problem was obvious with a fast logic analyzer.
    [LA.c, UI.c, fpga.c]
2019-08-09 use spi peripheral in fpga
2019-08-12 FPGA + SPI mode and logic analyzer working
2019-08-18 rework into three processing loops. hopefully non-blocking loops :P
    [HWSPI.c, UI.c]
2019-08-18 broken processing into three loops. Uses halt command in FPGA. Logic analyzer working. Need to get down into the modes files and figure out how the pre and post processing will work there
    [HWSPI.c, LA.c, UI.c, protocols.h]
2019-10-11 LCD display driver working. RGB test.
2019-10-24 added FIFO reset. FPGA state machine sync seems to be working much better.
    [HWSPI.c, UI.c, beta1.h, fpga.c, lcd.c]
2019-10-26 pre and post processing loops working with SPI read and write
2019-10-26 Flipped LCD 180 degrees so it writes left to right (font, positioning, etc). Added mode labels. Cleaned up LCD functions.
    [HWSPI.c, HiZ.c, buspirate.c, lcd.c, lcd.h]
2019-10-26 Cleanup compiler warnings. increase SPI speeds. modify LCD update handling.
