DangerousPrototypes/Bus_Pirate_Ultra/(notices)

Notices in the files:
source/cdcacm.c:
This library is free software: you can redistribute it and/or modify
it under the terms of the GNU Lesser General Public License as published by
the Free Software Foundation, either version 3 of the License, or
(at your option) any later version.
hardware/scratch/BusPirate-ultra-testboard.v1.0.brd:
LICENSE: CC-BY-SA
